zxygentoo/oberon-risc-hardcaml/docs/oberon-on-nexys4.jpg

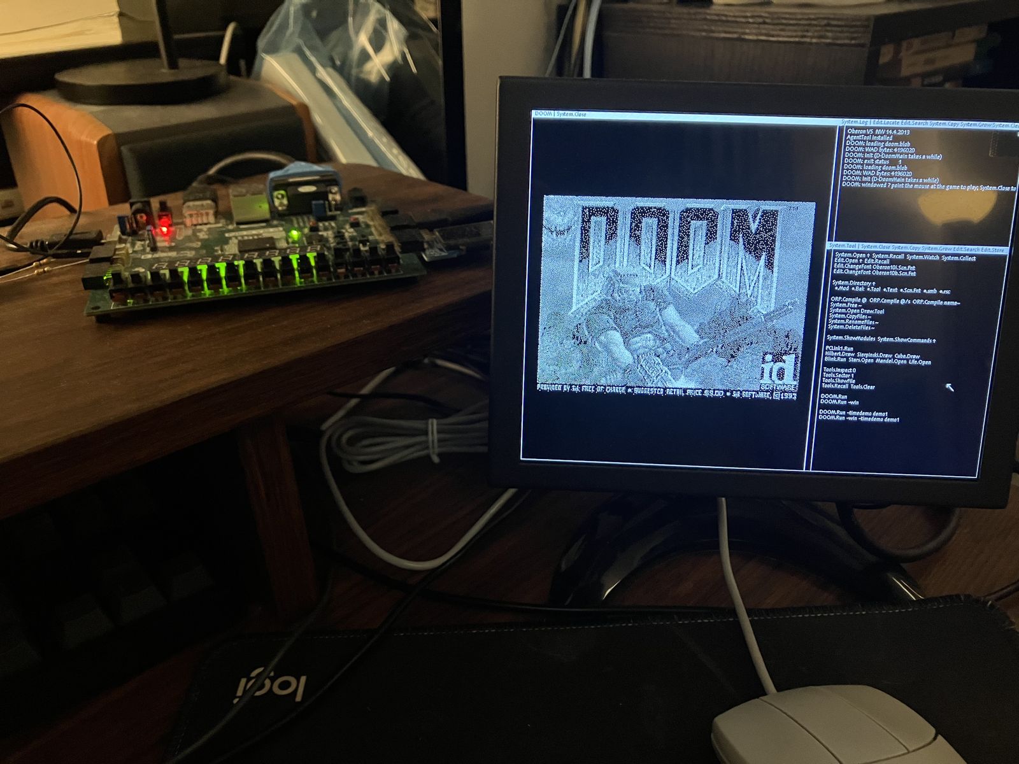
docs/oberon-on-nexys4.jpg
