zxygentoo/oberon-risc-hardcaml/(commit log)

2026-06-18 docs: record git-flow workflow conventions in AGENT.md
2026-06-18 docs: switch toolchain to OxCaml + Hardcaml v0.18~preview
    Record the toolchain decision in AGENT.md: the project builds on the 5.2.0+ox switch with Hardcaml v0.18~preview (the version docs.hardcaml.org documents), since vanilla opam tops out at v0.17.1. Adds locked decision #7 and rewrites the §9 toolchain/API notes (v0.18 labeled-arg shifts, log_shift ~f ~by, select ~high ~low, renamed int conversions, Rtl.print Rtl.Language.Verilog). Verified end-to-end on ox via a smoke test.
2026-06-19 chore: scaffold Phase 0 — dune project, oracle submodule, toolchain smoke
    Stand up the Hardcaml project on the OxCaml (5.2.0+ox) switch:
    - dune project: root (dirs lib test vendor); placeholder `risc5` design library
    (real modules from Phase 1).
    - Vendor the OCaml emulator as a git submodule (vendor/oberon-risc-emu-ocaml,
    pinned) and compile its lib/ into library `oracle` (Oracle.Risc/Fp/Boot_rom)
    via vendor/oracle — the in-process golden model for lockstep. The submodule is
    data_only so dune ignores its private project; the wrapper keeps it pristine.
    - test/test_scaffold.ml certifies the toolchain end to end (dune test green):
    oracle callable, Hardcaml build+simulate (v0.18 A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
2026-06-19 docs: refine §2 fidelity — faithful on timing, idiomatic on datapath
    Locate fidelity at the cycle-accurate boundary: mirror the sequential
    skeleton of RISC5.v (registers, stall/state-counter timing, multi-cycle
    units, interrupts) exactly, since that is what the oracle checks and what
    synthesis preserves; write idiomatic Hardcaml for the combinational
    datapath (shifters, ALU ops, muxes), where only the truth table is
    observable and synthesis re-maps structure freely.
2026-06-19 feat: add LeftShifter (LSL) as idiomatic log_shift one-liner
    Port of Oberon LeftShifter.v: y = x << sc (zero-fill, sc 0..31).
    Implemented with Hardcaml log_shift ~f:sll rather than Wirth radix-4 mux
    tree -- same combinational function; synthesis maps either form to the
    same LUT6 fabric (AGENT.md §2). I/O interface mirrors the Verilog ports
    (x[31:0], sc[4:0], y[31:0]); risc5.ml becomes the curated module index.
2026-06-19 build: generate opam file via dune for one-shot dep install
    (generate_opam_files true) + an (allow_empty) package stanza listing the
    toolchain (hardcaml, hardcaml_waveterm, ppx_hardcaml, ppx_expect, qcheck-core,
    core). opam install . --deps-only now reproduces the switch; the package carries
    dependency metadata only (the design lib is not published to opam).
2026-06-19 docs: correct §6 — co-located inline-test deps live in (libraries)
    (inline_tests (libraries ...)) only adds link-time deps to the generated test
    runner, not compile scope to the library modules. So tests co-located in a
    design module need their tooling (hardcaml_waveterm, qcheck-core) in the main
    (libraries). The emulator oracle is still kept out of lib by routing
    oracle-coupled lockstep tests to test/.
2026-06-19 test: co-locate LeftShifter tests (qcheck vs x lsl sc + waveform)
    Inline ppx_expect tests in left_shifter.ml: a 10k-case qcheck property
    against the pure-OCaml reference (x lsl sc) land 0xFFFFFFFF, and a frozen
    waveform of 1 << {0,1,4,16} plus 0xDEADBEEF << 4. lib/dune gains
    (inline_tests) + ppx_expect; hardcaml_waveterm and qcheck-core become library
    deps (co-located tests share the lib compile scope).
2026-06-19 docs: tighten §6 co-located-tests rationale (verified, not assumed)
    State co-location as the explicit default, with test/ reserved for
    oracle-coupled or system-level harnesses. Correct the mechanics caveat:
    the inline-test deps (hardcaml_waveterm, qcheck-core) are required in
    *every* profile — dune does not drop inline-test bodies in release — so
    the old "dropped from non-test builds" claim was wrong. The real reason
    co-location is acceptable is that those host-side deps never reach the
    generated Verilog (Rtl.print lowers the circuit graph, not OCaml deps).
    Verified empirically (dune 3.22, ppx_expect v0.18~preview):
    - (inline_tests (libraries …)) does not grant the lib compile scope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
2026-06-19 docs: add pre-commit gate (dune fmt + dune build @check)
    Before every commit, run dune fmt and dune build @check (the batch
    equivalent of merlin's in-editor diagnostics: type-checks every module
    and .mli, surfaces warnings which are errors in dev) and fix what they
    flag. If a flagged issue is not reasonable to fix — a false positive, a
    vendored/generated-code warning, or a fix that would compromise port
    fidelity (§2) — stop and notify the human instead of suppressing it.
2026-06-19 feat(right_shifter): add ASR/ROR unit (RightShifter.v) with co-located tests
    Port Oberon's RightShifter.v as the mirror of LeftShifter: a barrel
    right-shift selected by md — arithmetic (sign-fill, ASR) when md=0,
    rotate (wrap-fill, ROR) when md=1. Expressed idiomatically as two
    log_shift barrels (~f:sra, ~f:rotr) muxed on md; synthesis rebuilds
    Wirth's shared staged tree (AGENT.md §2). md = IR[16] in the core.
    Follows the locked conventions: right_shifter.{ml,mli} with the .mli
    contract owning the docs, and co-located ppx_expect tests — qcheck (10k)
    both modes vs plain-OCaml references, plus a frozen waveform showing
    ASR sign-flood and ROR half-swap/wrap.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
2026-06-19 refactor(shifters): drop now-unused shift helper from the public API
    With the ALU built as Option B — it does not fold the shifters in; their
    results join the result mux at the core — the `shift` combinational helper
    has no consumer. Inline it back into `create`, leaving each shifter with
    the clean I/O/create surface every other unit will have.
    The co-located tests already drove `create`, not `shift`, so they are
    unchanged and still pass.
2026-06-19 feat(alu): phase-1 step A — register-op result mux (ops 0,4..9) + waveforms
    New Alu module: the register-op results RISC5.v computes inline in its
    aluRes mux — MOV, the logic ops (AND/ANN/IOR/XOR), and ADD/SUB. Factored
    into its own unit for isolated tests (Option B: the shifts and MUL/DIV/FP
    are peer units selected at the Phase-4 core, so those op slots read as 0).
    Co-located tests:
    - qcheck, 20k cases over ops {0,4..9} vs an independent OCaml reference
    - two curated waveforms (display_rules) documenting the subtle bits: the
    ADD'/SUB' carry-in and the MOV forms
    The N/Z/C/OV flags follow in step B.
2026-06-19 feat(alu): step B — C/OV flags
    Carry/borrow and signed overflow from one-bit-wider add/sub: an unsigned widen gives result + carry/borrow (msb), a signed widen gives overflow (top two bits disagree). ADD/SUB own C/OV; every other op passes the current flags through. Shared addsub helper over (+:)/(-:). Verified by the 20k qcheck (res+c+ov vs OCaml refs) plus the carry-vs-overflow waveform.
2026-06-19 docs: swap phases 2↔3 (register file first); N/Z is Phase-4 (from regmux)
    N/Z derive from the final regmux (RISC5.v:159-160), not from the ALU's own result — so they're a core-integration signal, computed once at the CPU core. Move them off the Phase-1 row onto Phase 4; Phase 1 keeps C/V only. Reorder: register file (smaller, independent leaf) becomes Phase 2, MUL/DIV/FP becomes Phase 3. Make alu.mli's H comment phase-agnostic so it won't go stale on reorders.
2026-06-20 style: pin waveform widths (wave_width 4) and clarify alu MOV comment
    Narrow the frozen [%expect] waveforms to wave_width 4 with pinned ~display_width (alu 58, left/right_shifter 70) so a rolling v0.18~preview waveterm default can't silently reflow the frozen ASCII. Reword alu.ml's MOV comment to read the mux2 tree as a hardware if. Document the waveform-width rule in §6.
2026-06-20 refactor(registers): open! Base instead of Core
    registers.ml uses only Base-level APIs (Array, List, int =), so Base — the lean subset — is the right import, not Core; bang the Stdlib-replacement open per JS convention. Base resolves transitively via Hardcaml (as Core did), so no lib/dune entry needed. §9 reworded: Base + open! is the design-lib default, Core only where a module needs its extras.
2026-06-20 docs: split phase 3 into 3a (MUL/DIV) and 3b (FP units)
    3a's proof is pure-OCaml integer reference math (no fp_vectors); 3b's is
    the frozen fp_vectors.txt — a clean oracle seam that already existed
    implicitly in the old combined row. Also record the unsigned-MUL' high-word
    divergence in §8: Multiplier.v sign-extends C1 unconditionally, so MUL'
    computes B_u × C1_s while both emulators compute B_u × C1_u (differs in H
    only when C1[31]=1) — a new Phase-4 lockstep steer-around.
2026-06-20 feat(multiplier): iterative shift-and-add MUL unit (Multiplier.v)
    33-cycle sequential signed/unsigned 32x32->64 multiply, mirroring RISC5.v's
    skeleton exactly: 6-bit state counter S (run-gated, no reset), stall =
    run & ~(S==33), and the dual-role 64-bit P register that accumulates via a
    33-bit sign-extended add then shifts right one bit per multiplier bit.
    Idiomatic Hardcaml reg_fb for the two feedback registers (S in scope when
    defining P, so P's feedback can test S==0/S==32).
    Tests (co-located, AGENT.md §6): qcheck the full multiply against a pure-OCaml
    Int64 reference for both modes (2000 cases), encoding the hardware semantics
    (y always signed; x signed iff u=1, so unsigned MUL' = x_un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
2026-06-21 docs: clarify cycle-fidelity framing (§2); add Phase 9 optimization stretch
    §2 said cycle-accuracy is "what the oracle checks cycle-by-cycle" — but the OCaml
    oracle is instruction-level (ms-clock injected via set_time, steps by instruction),
    so it proves behavioral correctness and needs no cycle-accuracy. Reframe: cycle-
    fidelity is held for the exhaustive Phase-8 equivalence proof vs RISC5.v, RISC5.v as
    a cycle-level debugging oracle, and the bright-line discipline — not for the
    behavioral pyramid (Phases 4-5). Add Phase 9 (stretch): optimize from the verified,
    Phase-8-proven baseline, judged against the ISA/oracle with cycle-accuracy relaxed.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
2026-06-21 feat(divider): iterative restoring DIV unit (Divider.v)
    33-cycle sequential signed/unsigned divider, the Multiplier's twin: same 6-bit
    state counter S (run-gated, no reset), stall = run & ~(S==33), and a dual-role
    64-bit RQ register holding remainder|quotient (high|low). S=0 loads |x| into the
    low half; S=1..32 each run one restoring step -- shift {R,Q} left one bit
    (RQ[62:31]), trial-subtract y, then keep the difference (quotient bit 1) or
    restore the old remainder (quotient bit 0). Signed mode divides |x| then
    sign-corrects the outputs to floored division with a non-negative remainder
    (-q-1 = ~q in two's complement).
    Precondition y in [1, 2^31-1] (Wirth's // y > 0): the restoring step's
    r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
2026-06-22 feat(fp-adder): pipelined FPAdder + FLT/FLOOR (FPAdder.v)
    3-stage pipelined IEEE-754 single add/sub plus the FLT (int->float) and FLOOR
    (float->int) conversions -- a faithful port of FPAdder.v: 2-bit State counter,
    run-gated with no reset, stall = run & ~(State==3), and the three pipeline
    registers (x3/y3 align, Sum add, t3 post-normalize). The combinational datapath
    is idiomatic Hardcaml (log_shift for the denormalize/normalize barrel shifts),
    but the leading-one detector + shift-count encoder are transliterated bit-for-bit
    from the RTL -- a priority encoder is where an idiomatic rewrite could silently
    diverge. FLT/FLOOR select via the u/v modifier bits; the facade exposes Fp_adder.
    Verifi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
2026-06-22 test(cosim): RTL-fidelity co-sim via Verilator (FPAdder)
    Opt-in harness (not dune runtest) confirming the Hardcaml design is bit-exact to
    Wirth's original Verilog: drive the reference RTL through Verilator and compare
    against the port. The simulation preview of the Phase-8 hardcaml_verify proof,
    and the project's *fidelity* oracle -- distinct from the OCaml emulator's
    behavioral/system role.
    dump_fp_adder.ml Hardcaml Fp_adder -> "x y u v z" over a stimulus set
    fp_adder.cpp Verilator harness: replay each line through FPAdder.v, compare z
    run.sh build dumper -> dump -> verilate -> cross-check
    README.md purpose, deps, how to run, how to add a unit
    bash test/co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
2026-06-22 docs: reframe verification (§6) — two oracles (emulator + RTL co-sim)
    Name the two complementary oracles explicitly: the OCaml emulator (system-state,
    instruction granularity, layers 4-5) and the original Verilog via Verilator
    (wire-state, cycle granularity, our test/cosim/) -- the §2 fidelity authority,
    added as pyramid layer 3 (exhaustively at layer 6). Records that every §8
    divergence is emulator-vs-RISC5.v with the port following the RTL (co-sim proves
    it), makes the FP-vector replay reachable-domain, and adds the FP FLT/FLOOR
    denormalize-fill divergence to §8. Tooling reality in §9: hardcaml_verify
    installed, hardcaml_of_verilog blocked on the preview (jsonaf portability),
    hardca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
2026-06-22 feat(fp-multiplier): pipelined iterative FPMultiplier.v port + timing test
    Port Oberon's FPMultiplier.v (the RISC5 FML unit): a 24-bit shift-and-add
    mantissa multiplier — the integer Multiplier in miniature — wrapped in the
    combinational FP exponent/round/repack logic. Mirrors the RTL's sequential
    skeleton (AGENT.md §2): a 48-bit dual-role P register and a run-gated 5-bit
    state counter S, with stall = run & ~(S==25).
    The co-located expect test pins the cycle timing (stall envelope S 0->25) plus
    one oracle-free sanity value (FML 2.0*2.0 = 0x40800000); exhaustive value
    correctness is the Verilator co-sim's job. Re-export Fp_multiplier from the
    curated risc5.ml index.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
2026-06-22 test(cosim): consolidate FP dumpers + fetch reference RTL on demand
    Consolidate the per-unit dumpers into a single dump_fp.ml selected by a
    unit-name argument: a shared run->drain->read protocol over a small per-unit
    `driver` record (the FP units differ only in the u/v modifiers and the A/M/D
    vector tag). Adds the fp_multiplier co-sim harness.
    Make the co-sim painless for a fresh clone. The original Project Oberon Verilog
    is not vendored (unclear licensing); run.sh's ensure_rtl fetches
    OStationVerilog.zip on demand into _po/ and checksum-verifies it against
    test/cosim/rtl-sources.txt (per-file SHA-256 pins — a mismatch means upstream
    drifted from the revision the port and AGENT.md §8 wer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
    [fp_adder.cpp, fp_multiplier.cpp]
2026-06-22 feat(fp-divider): restoring-division FPDivider.v port + co-sim
    Port Oberon's FPDivider.v (the RISC5 FDV unit): a restoring-division divider
    forming the 24-bit-mantissa quotient over 26 cycles, under the same FP
    exponent/round/repack wrapper as the multiplier — the dual of shift-and-add.
    Mirrors the RTL skeleton (AGENT.md §2): R (24-bit remainder) + Q (26-bit
    quotient) + a run-gated 5-bit S, stall = run & ~(S==26). R's next value and Q's
    next bit both feed off the same trial subtraction, so they are forward-declared
    wires closed through reg (the register breaks the apparent cycle).
    Co-located test pins the timing (stall S 0->26) + a sanity FDV 6.0/2.0=3.0; wire
    its driver into the shared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
    [fp_divider.cpp]
2026-06-22 test(fp): always-on value-correctness replays (FAD/FML/FDV) via shared Fp_replay
    Add the FP units' behavioural layer to `dune runtest`, independent of the opt-in
    Verilator co-sim (AGENT.md §6): replay the frozen fp_vectors result columns
    against the Hardcaml ports, plus a fuzz vs Oracle.Fp.
    FML/FDV have no emulator-vs-RTL divergence (verified: 2576/2576 frozen + 20k
    random each, 0 fail), so they need no steering and collapse to one
    Fp_replay.simple_value_test call apiece. The adder keeps its reachable-domain
    steering (the FLT/FLOOR magic operand) inline but now shares the sim-drive
    protocol, vector loader and RNG via Fp_replay — the per-unit `run` closure hides
    the u/v interface differen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
2026-06-22 feat(cpu-core): fetch/decode/stall spine (Phase 4.0)
    Stand up Risc5_core, the port of RISC5.v: the final SoC-facing I/O interface,
    and the fetch/decode/stall spine in one Always.compile block mirroring Wirth's
    single always @(posedge clk). This slice brings:
    - PC/IR/stallL1 — the three fetch-timing registers (the other nine land in
    4.1-4.5); faithful no-reset registers, rst_n reaching the datapath as logic.
    - decode of the four mode bits + LDR/STR (the rest is decoded per later slice).
    - stall aggregation (stallL0 | stallX; the unit stalls OR in at 4.2).
    - the reset/stall/step next-PC ladder (branch/intAck/RTI join at 4.3/4.5).
    - final memory-bus control strobes rd/wr/ben; adr's data br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
2026-06-22 feat(cpu-core): register-op datapath + lockstep (Phase 4.1)
    Wire the register-op datapath into the core and prove it against the oracle.
    Datapath (4.1a):
    - Operand path: the register file (Registers), ira0 (branch-link write addr),
    and the C1 immediate mux; B/C1 fan out to the shifters + Alu into the
    op-indexed result mux (MUL/DIV/FP slots read 0 until 4.2).
    - Writeback + flags: regmux (the ALU result for a register op), regwr, and the
    N/Z/C/OV registers (N/Z from the written value, C/OV from the Alu). outbus now
    drives A (RISC5.v:132, the ~ben case) — faithful, and it makes the datapath
    observable instead of dead-code-pruned.
    - registers.ml: name the regfile memory ("regfile")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
2026-06-22 feat(cpu-core): multi-cycle units MUL/DIV/FP + H (Phase 4.2)
    Wire the multi-cycle units into the core and verify all 16 register ops.
    - Instantiate Multiplier/Divider (B/C1, the inverted u-bit) and the three FP
    units (B/C0, with FSB's operand-2 sign flip); their results fill result-mux
    slots 10..15. OR the five unit stalls into the stall aggregation (which makes
    regwr a forward wire, like regmux). Add the H register (MUL high word / DIV
    remainder), now feeding the Alu's MOV' H-read.
    - Co-located waveform: a MUL freezes the core (PC/IR held, stall high) then
    writes back product[31:0] + H on the cycle stall drops.
    - test/test_cpu_lockstep.ml: extended to ops 0..15 — multi-cycle re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
2026-06-22 test(fp): migrate fuzz passes to QCheck + restructure
    Bring the FP units' random fuzz passes onto QCheck, matching the lib unit tests
    and the CPU lockstep: int32 generators give boundary coverage (0/min/max) and
    shrink a failure to a minimal counterexample. The deterministic parts are
    unchanged — the frozen fp_vectors replays and the FLT/FLOOR edge-value list stay
    plain loops (they were never randomized).
    Also break the two monolithic let () bodies apart for readability:
    - fp_replay.ml: simple_value_test -> replay_simple + fuzz_xy + a composer.
    - test_fp_adder.ml: -> make_run / replay_reachable / fuzz_conversions + a driver.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
2026-06-22 feat(cpu-core): branches — cond, target mux, link-to-R15 (Phase 4.3)
    Wire the branch control path (RISC5.v:137-153):
    - cond: the branch condition (the §7 cc table on N/Z/C/OV/S, negated by IR[27]).
    - pcmux0: a taken branch goes to PC+1+disp (relative) or R.c>>2 (register), else
    falls through to nxpc; pcmux now uses pcmux0.
    - link: a taken linking branch (BR & cond & v) writes the return byte-address
    {PC+1, 2'b0} to R15 (= ira0, wired in 4.1) via regmux/regwr.
    Co-located waveform: a taken BL jumps and links R15; a not-taken branch falls
    through.
    Lockstep (test/test_cpu_lockstep.ml): a second QCheck test, 50k branch cases
    reusing the create/step/agree harness. Targets are steered into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
2026-06-22 feat(cpu-core): load/store data path (Phase 4.4)
    Wire the load/store data path onto the 2-cycle stallL0 dance from 4.0:
    - off (IR[19:0], 20-bit signed) and the data address B[23:0] + sign-extend(off);
    adr is that data address during stallL0, else the fetch address.
    - inbus1: a byte load selects the lane at adr[1:0] from inbus and zero-extends, a
    word load passes inbus through; this feeds regmux's LDR term, and regwr gains
    the load write enable.
    - outbus: a byte store replicates A[7:0] into the addressed lane, a word store
    drives A.
    Co-located waveform: a word load and a byte store, each a 2-cycle access (data
    address + rd/wr strobe while PC/IR freeze, then a bubble).
    Lockstep (test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
2026-06-22 feat(cpu-core): interrupts — intAck, vector dispatch, RTI restore (Phase 4.5)
    Wire RISC5.v's interrupt FSM, the last slice of the CPU core:
    - Five registers (RISC5.v:34-35,178-182): irq1 (edge detector), intEnb
    (STI/CLI-written), intPnd (pending — set on a rising IRQ edge, cleared on
    ack), intMd (in-handler — set on ack, cleared by RTI), and SPC = {flags,
    return PC}.
    - intAck (RISC5.v:149) = intPnd & intEnb & ~intMd & ~stall.
    - pcmux (RISC5.v:150-152) becomes the priority ladder reset > stall > intAck
    (-> vector address 1) > RTI (-> SPC[21:0]) > branch/step.
    - The flags gain an RTI restore from SPC[25:22] (RISC5.v:159-166).
    - RTI and STI/CLI decode (RISC5.v:96,181).
    Verificati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
2026-06-22 docs: mark Phase 4 (CPU core) complete
    The full RISC5.v core is ported and verified across the 4.0-4.5 slices. Note in
    the proof column that the interrupt FSM (4.5) is the one part with no OCaml
    oracle (the emulator models no interrupts), so it is checked by a behavioural
    waveform against RISC5.v rather than by instruction lockstep.
2026-06-22 test(cosim): cycle-fidelity check — assert RTL stall length == port (FP units)
    The FP co-sim asserted only RTL z == port z (each side read when its own stall
    dropped), so a cycle-count divergence would have slipped through. Add a
    stall-length comparison on top:
    - dump_fp.ml: drive now counts the clock cycles with run asserted until stall
    drops (= the unit's state-counter terminal) and dumps it as a trailing column.
    - fp_{adder,multiplier,divider}.cpp: run_op counts the RTL's stall the same way,
    and main compares it to the port's, exiting nonzero on a value OR cycle
    mismatch.
    Verified against the reference Verilog (bash test/cosim/run.sh): all three units
    bit-exact AND cycle-exact o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
    [fp_adder.cpp, fp_divider.cpp, fp_multiplier.cpp]
2026-06-22 style(cpu-core): shrink MUL tail waveform to fit its 3 cycles
    The MUL test's tail [%expect] rendered at display_width 70 (sized for the head's
    5 cycles) but carries only 3 cycles of content, leaving two empty cycle-columns.
    Drop it to 44 — the 58/70-for-4/5-cycle progression puts 3 cycles at ~44 — so
    the result (regmux = 0x2A) keeps ~2 trailing spaces, unclipped. The head stays
    at 70 (it needs all five). Waveform only; no logic change.
2026-06-22 refactor(cosim): hoist shared tick+drain protocol into fp_cosim.h
    The three FP co-sim harnesses each carried an identical clock tick() and a
    run->drain->count run_op() — the latter triplicated when the cycle-fidelity
    check landed. Extract both into a templated fp_cosim.h (over the Verilator top
    type, which all three units expose as clk/run/stall/z/eval), so the drive
    protocol and its cycle count have a single definition. Each <unit>.cpp is now
    just its stimulus loop; the main()s stay local because they legitimately differ
    (the adder's u/v modifiers, the dumped-line arity). -79 lines net.
    Verified via test/cosim/run.sh: all three still bit-exact AND cycle-exact
    (26304 / 22576 / 22576 stimu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
    [fp_adder.cpp, fp_divider.cpp, fp_multiplier.cpp]
2026-06-23 docs: flag hardcaml_step_testbench as a Phase-6 evaluation
    Researched hardcaml_step_testbench and hardcaml_event_driven_sim for our testing.
    event_driven_sim is an event-driven paradigm with no role in this single-clock
    synchronous design. step_testbench (a testbench monad with concurrent agents)
    doesn't fit the white-box, cycle-exact core/lockstep tests, but is well-suited to
    the Phase-6 serial peripheral protocols (UART/SPI/PS2) — noted in the plan to
    evaluate then. Both install clean on ox (2 packages, deps already present);
    neither is installed.
2026-06-23 docs: clarify §2 fidelity — semantics not surface, idiomatic readable code
    Sharpen the mandate with what we settled while refactoring the core: Phases 0-8
    are cycle-/bit-exact *behaviour*, not surface-syntax/style matching to RISC5.v —
    so write idiomatic, clean, readable Hardcaml. Records bound to meaningful names
    with dot-notation field access are a free namespace; comment the why and the
    load-bearing mechanic, not a line-by-line footnote to the RTL. The only surface
    held fixed is the timing skeleton and the register names (the lockstep reaches
    them by name).
2026-06-23 refactor(cpu-core): stage create as decode/execute/memory; dot-access; comment pass
    Reorganize risc5_core.ml for readability — behaviour byte-identical (the 200k-case
    lockstep and the co-located waveforms are all unchanged; same netlist, pure
    source-level reshaping):
    - Factor the datapath into named stages: decode (IR -> fields record), execute
    (shifters/ALU/MUL/DIV/FP + result mux), memory (address, byte lanes, strobes).
    create now reads top-to-bottom as the loop: decode -> fetch operands -> execute
    -> memory -> control -> writeback -> commit.
    - Uniform dot-access: bind sub-modules and stages to meaningful names and reach
    their outputs by field (alu.res, mul.stall, ex.result, mem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
2026-06-23 test(cpu-lockstep): rename arbitrary_* generators to seed_*
    The QCheck generators feed decode/decode_branch/... which turn a raw draw into a
    lockstep case, so `seed` reads better than `arbitrary` (seed -> decode -> case).
    Pure rename; lockstep unchanged.
2026-06-23 docs(lib): comment cleanup — why/mechanic over RTL-line footnotes (FP + mul/div + alu)
    Apply the §2 "semantics not surface" comment philosophy to the remaining design
    modules. The inline Verilog-expression footnotes that restated each line in RTL
    notation — (* {P[63],P[63:32]} *), (* P[0] ? y : 0 *), (* e0 - 127 + P[47] *) —
    become plain-English why/mechanic notes, or are dropped where the header already
    covers them; the header meta-claims ("each create line is tagged with the wire
    it ports") go. High-level "ports <File>.v" pointers, AGENT.md §N refs, mux-arm
    labels and register-role notes stay; alu's 0x53-vs-0xD0 §8 divergence why was
    made explicit.
    Touched: alu, multiplier, divid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
2026-06-23 refactor(cpu-core): rename stage bindings d->dec, ex->exe for readability
    The decode and execute stage results in create read clearer spelled out (dec,
    exe) than the single/double-letter d/ex, including in the execute/memory helper
    params (~(dec : decoded)). Pure rename — behaviour byte-identical (200k lockstep
    + every co-located waveform unchanged; the (--) naming strings are untouched).
2026-06-23 refactor(fp-adder): extract leading-one detector + encoder as shift_count
    Stage 2's ~48-line leading-one detector (z24..z2) + shift-count encoder
    (sc4..sc0) move into a top-level shift_count helper (s -> sc, one in / one out),
    so create's Stage 2 reads as four lines instead of a wall of priority-encoder
    boolean logic. The helper carries the §2 note that it's transliterated
    bit-for-bit — a priority encoder is exactly where an idiomatic rewrite could
    silently diverge.
    Pure refactor, netlist byte-identical: the FP frozen vectors, the timing
    waveform, and the Verilator co-sim (26304 stimuli, 0 value-mismatch, 0
    cycle-mismatch -> bit- AND cycle-exact to FPAdder.v) are all unchanged. create
    bo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
2026-06-24 feat(sram): 1 MiB single-port async SRAM model, byte-enable writes
    Second Phase-5 memory module. Models the OberonStation's external async SRAM as four byte-lane memories (256 Ki x 8) sharing the word address; per-lane write-enable (wr & (~ben | lane==k)) is the SRbe semantics directly, avoiding a read-modify-write for sub-word stores. Async read; zeroed at reset (matches the oracle).
    Single-port by design — the video-DMA address-steal mux + stall_x live at the SoC level (RISC5Top's SRadr mux), which is why the core stalls during DMA. Named Sram (not Ram) to avoid shadowing Hardcaml.Ram under open Hardcaml.
    Tests: qcheck 500 mixed word/byte sequences vs a word-array model + a frozen wave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
2026-06-24 feat(soc): minimal Phase-5 SoC — core + boot ROM + RAM + address decode
    Wires the RISC5 core to Prom + Sram through RISC5Top's decode: codebus = adr[23:14]==0x3FF ? rom : ram (fetch), inbus = adr[23:6]==0x3FFFF ? io : ram (load), stores to Sram. The adr->mem->codebus/inbus feedback is broken by the core's pc/ir registers, so codebus/inbus are wires assigned after the core is built.
    Skeleton: irq/stall_x tied low, MMIO read mux stubbed to 0 — the ms-timer + IO mux (5.2b) and state-as-outputs for the hardcaml_c lockstep (5.2c) come next. Integration test (no oracle): a hand-assembled boot stub fetches MOV/ST/LD from ROM and round-trips a word through RAM (R1=R2=0x55 via the named regfile)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
2026-06-24 docs: retarget board to Nexys 4 (non-DDR), Cellular PSRAM memory story
    Physical board is the original Digilent Nexys 4, not the Nexys 4 DDR. External memory is 16 MiB Cellular PSRAM (Micron M45W8MW16) with an async-SRAM interface and async auto-refresh, so the Phase-7 memory layer becomes a light 16/32-bit width-adapter FSM over an SRAM controller with ~70 ns wait-states through the existing stall path (no MIG/DDR2). Rewrites section 4 and its companions (2.3/2.5/3/5 Phase 7) plus the board name in dune-project and the .opam. Grounded in _po/nexys4_rm.pdf section 3.
2026-06-24 feat(soc): millisecond timer + MMIO read mux (5.2b)
    RISC5Top's free-running ms timer: a clocks_per_ms prescaler (cnt0) raises limit once per ms, driving the core's irq and ticking the ms counter cnt1 (read at MMIO word 0). The MMIO read mux routes word 0 -> cnt1, other words -> 0 (peripherals are Phase 6). New ?clocks_per_ms param (default 25000 = 1 ms @ 25 MHz; faithful default, lowered in tests).
    Tests: cnt1 ticks to 2 after 60001 cycles at the faithful 25000 prescaler; the MMIO mux distinguishes IO (R1 = cnt1, non-zero) from RAM (R2 = 0x55); the 5.2a round-trip stays green.
2026-06-24 docs: reframe Phase-5 lockstep backend — interpreter, not hardcaml_c
    Profiling (2026-06-25) showed the plain Cyclesim interpreter is fast enough for the boot lockstep (~0.39 M cycles/s -> ~1 min boot golden; trace_all for lookup_* is free), while hardcaml_c gives only ~3.5x at the cost of minutes per -O2 compile of a 63 MB / ~1M-line eval.c, and hardcaml_verilator won't build vs Verilator 5.048. Updates AGENT.md sections 5/6/9 and the soc.{ml,mli} comments; the state-as-outputs / debug-bundle plan (5.2c) is dropped since the interpreter's lookup_reg/lookup_mem reach the state directly.
2026-06-24 docs: reframe Phase-5 verification — boot-handoff checkpoint, SPI into Phase 5
    Per-instruction oracle lockstep through a boot is the wrong tool: the §8
    code-address skew while running from ROM, the interrupt-free oracle, its
    injected vs cycle-derived ms-clock, and SD/timer poll timing all diverge
    step-by-step without diverging in result. The §8 skew is confined to ROM and
    self-heals in low RAM, so boot is verified by a checkpoint at the OS handoff.
    SPI/SD — the one peripheral boot needs — moves into Phase 5; the rest stay
    Phase 6.
    Updates §5 plan (Phase 5/6 rows), §6 layer 5, and §8 addressing.
2026-06-24 feat(spi): SPI master — faithful port of SPI.v
    One 32-bit shift register serves two SD-card rates (slow clk/64 byte for init,
    fast clk/3 word for bulk), selected by `fast`. Cycle-accurate to SPI.v: the
    tick clock-divider, bitcnt, the rdy handshake, and the four-lane chained shift
    permutation that serialises fast words LSByte-first while keeping each byte
    MSbit-first — transcribed bit-for-bit since it is observable (§2). Active-low
    synchronous reset woven into next-state, matching the core's style.
    Co-located tests: slow loopback (512 cycles, 0xA5 round-trips), fast loopback
    (96 cycles, 0x12345678 round-trips — exercises the permutation), and a short
    structural waveform. The exhaustiv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
2026-06-24 feat(soc): wire the SPI master into the SoC
    RISC5Top SPI MMIO: a store to word 4 pulses spiStart (dataTx = outbus),
    word 5 is the 4-bit spiCtrl (bit 2 = fast); reads return data_rx (word 4)
    and {31'b0, rdy} (word 5). Adds a miso input and mosi/sclk outputs — the
    SD card is off-chip, driven test-side. spiStart/spiCtrl are transcribed
    verbatim from RISC5Top; store routing is unchanged (the SRAM tristate is
    .T(~wr) with no ioenb gate, so unconditional RAM writes stay faithful).
    Integration test: a boot-style exchange (start, poll rdy, read back) with
    a loopback SD card round-trips 0xA5 through the full MMIO→SPI→MMIO path.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
2026-06-24 perf(test): build the SRAM qcheck sim once (47 s → 0.5 s)
    The SRAM property created a fresh Cyclesim sim inside the per-case function,
    rebuilding the 1 MiB memory model (4 × 256 Ki byte lanes) on all 500 sequences —
    ~48 s, the dominant cost of `dune runtest`. Build the sim once and zero the
    16-word test window at the start of each sequence instead. Full `dune runtest`
    drops from ~60 s to ~2.5 s.
2026-06-24 test(cosim): RTL-fidelity co-sim for the SPI master
    Verilator co-sim proving Hardcaml Spi is bit- and cycle-exact to SPI.v — the
    serial-peripheral analog of the FP units' z+stall-length check, and the closing
    gap noted in spi.ml (layer-3 fidelity was deferred there).
    dump_spi.ml drives Risc5.Spi over 658 transfers (corner words x both rates +
    fuzz, biased to the cheap fast mode) with a deterministic, recorded per-cycle
    MISO — independent of MOSI, not loopback, so a sample-timing bug can't hide
    behind MISO happening to equal the bit being shifted out. Each cycle is encoded
    as one hex digit (miso/rdy/sclk/mosi); spi.cpp replays the recorded MISO through
    SPI.v, drains on the RTL's own rdy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
    [spi.cpp]
2026-06-24 test: retire Phase-0 scaffold smoke, subsumed by the real suite
    The scaffold certified three wiring facts — oracle callable on ox,
    Hardcaml build+Cyclesim, hardcaml_waveterm render — each now exercised
    many times over by the real tests (every FP replay and the CPU lockstep
    link/call the oracle; all test_* build and simulate circuits; the lib's
    co-located let%expect_test waveforms drive hardcaml_waveterm). It was a
    Phase-0 milestone marker with no remaining coverage.
    Drop test_scaffold from test/dune and update the four AGENT.md
    references (§6 harness/mechanics, §9 "verified end to end" + repo
    layout) to point at the real suite. §5 Phase-0 row kept as history.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
2026-06-25 refactor(cosim): split fetch from runner, table-drive units, add @cosim alias
    run.sh had grown to ~150 lines doing four unrelated jobs (env, RTL
    provenance/fetch, per-unit orchestration with duplicated cosim_unit /
    cosim_spi / run_one, dispatch). Untangle it:
    - Extract the fetch + checksum-verify (ensure_rtl) into a standalone,
    toolchain-free fetch-rtl.sh. rtl-sources.txt stays as the reviewable
    provenance pin.
    - Collapse the per-unit functions to a units_table (one row each:
    name .v top .cpp dumper) driving a single cosim_unit. Adding the CPU
    core / peripherals is now a one-row edit. SPI's only difference (own
    dumper, no fp_vectors arg) is one column + one conditional.
    - Add a `d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
2026-06-25 fix(test): resolve boot-checkpoint disk path from project root
    The disk image path was relative to the test run directory
    (_build/default/test), so it only resolved when launched by the
    @boot_checkpoint rule — `dune exec -- test/test_boot_checkpoint.exe`
    from the repo root failed with "No such file or directory".
    Find the project root dynamically by walking up for the dune-project
    marker, then resolve the disk against it. The marker sits at both the
    real root and dune's _build/default mirror, with the disk at the same
    vendor/ offset under each, so it works from any cwd — the rule and a
    bare `dune exec` alike. Verified: CHECKPOINT PASS via both.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
2026-06-25 docs: split Phase 6 into 6a/6b; defer step_testbench + event_driven_sim
    Phase 6 is now 6a (remaining peripherals, each ported + unit-verified with the proven co-located + Verilator-cosim stack) and 6b (SoC top + the visual golden, extending the boot-handoff checkpoint over the framebuffer RAM region).
    hardcaml_step_testbench + hardcaml_event_driven_sim were evaluated (an SPI A/B spike) and deferred: heavier than the manual Cyclesim loop for our single-driver serial peripherals, and the cosim is their fidelity oracle. Revisit only at the PS/2 mouse (bidirectional concurrency).
2026-06-25 feat(uart): RS232T transmitter — faithful port of RS232T.v
    First Phase-6a peripheral. Baud divider (tick) + 9-bit shift register with implicit UART framing: loading {data, 1'b0} on start drops the start bit into the LSB, and shifting 1s in from the top yields the stop bit and idle line; bitcnt counts the 10 bit-times, run/rdy frame the transfer. fsel selects 19200/115200 (clk/1302 or clk/217 at 25 MHz). Sequential skeleton mirrors the RTL exactly; active-low synchronous reset woven into next-state (clock-only Reg_spec).
    Co-located tests (proven stack): functional frame decode (sample txd at bit centres, recover start/8-data-LSB-first/stop + rdy handshake), both-baud-rates, qcheck round-tr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
2026-06-25 test(cosim): RTL-fidelity co-sim for the RS232T transmitter
    Cycle-by-cycle Verilator check of Risc5.Rs232t vs _po/verilog/src/RS232T.v, following the SPI template: dump_rs232t drives (fsel, data) and records per-cycle (rdy, txd) over corner bytes in both baud rates + fuzz; rs232t.cpp replays the same stimuli through RS232T.v and asserts (rdy, TxD) match every cycle plus equal frame length. Output-only, so no value column — txd is the value, checked each cycle.
    Passes: 88 stimuli, 0 wave-mismatch, 0 cycle-mismatch — bit-exact and cycle-exact. Wires the unit into run.sh's units_table + the @cosim dune rule, pins RS232T.v in rtl-sources.txt, and exports Risc5.Rs232t (the cosim is its first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
2026-06-25 refactor(cosim): extract shared stall-based runner; collapse FP harnesses
    run_drain_cosim (+ cosim_open, Unit, parse_xy/parse_xyuv) in fp_cosim.h now owns the open -> run -> drain -> compare -> summary loop, so fp_adder/multiplier/divider.cpp drop to ~17-line shells (name the Unit, pick the parser). All five cosim units stay bit- AND cycle-exact (FP x3 + SPI + RS232T, 0 mismatches).
    Serial harnesses (spi/rs232t) left as-is; AGENT.md 6a notes a closing cosim-dedup pass (a shared serial runner across SPI/RS232x/PS2) deferred to the end of 6a.
    [fp_adder.cpp, fp_divider.cpp, fp_multiplier.cpp]
2026-06-25 feat(uart): RS232R receiver — faithful port of RS232R.v
    The receiver half of the UART (MMIO words 2/3). Three ideas beyond the transmitter: a 2-FF synchronizer (Q0/Q1) on the async rxd with start-edge detect (Q1 & ~Q0); mid-bit sampling (midtick = tick == limit/2) for noise margin; and nine windows (start + 8 data) with the start bit shifted off an 8-bit shreg so it ends holding the byte LSbit-first. run/stat frame the receive; done_ (a keyword-dodge for done) or reset clears rdy. Clock-only Reg_spec, reset woven into run/stat per the RTL.
    Co-located tests: recover-a-byte + done clears rdy, both baud rates, qcheck round-trip, and a start-detect waveform (rxd -> q0/q1 -> start_edge -> run)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
2026-06-25 test(cosim): RTL-fidelity co-sim for the RS232R receiver
    The receiver is input-driven, so a fixed-length trace replay: dump_rs232r plays the sender (drives a frame on rxd + a done_ ack, both baud rates + fuzz) and records per-cycle (done_, rxd, rdy) + the recovered byte; rs232r.cpp replays the same rxd/done waveform through RS232R.v and asserts RTL rdy == port's every cycle plus RTL data == port's whenever rdy is high.
    Passes: 52 stimuli, 0 value-mismatch, 0 wave-mismatch — bit- and cycle-exact. Wires the unit into run.sh + the @cosim rule, pins RS232R.v, exports Risc5.Rs232r. (The reference port is RxD, not rxd.)
    [rs232r.cpp]
2026-06-25 feat(kbd): PS/2 keyboard receiver — faithful port of PS2.v
    Recovers bytes from the device-clocked PS/2 stream. Three ideas beyond the UART: clock recovery (shift = Q1 & ~Q0 on each ps2c falling edge — the device's clock is the timing, no baud divider); a walking start bit (an all-1s 11-bit shreg where the start bit walks to bit 0 in exactly 11 shifts, self-timing the frame — no bit counter); and a 16-byte FIFO (a multiport_memory, one sync write at inptr on endbit + one async read at outptr, like the register file) buffering keystrokes. done_ (keyword-dodge) pops. Clock-only Reg_spec, reset woven into shreg/inptr/outptr per the RTL.
    Co-located tests: recover-a-scancode + done pops; th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
2026-06-25 test(cosim): RTL-fidelity co-sim for the PS/2 keyboard
    Input-driven fixed-length replay like RS232R: dump_ps2 plays the keyboard (clocks 11-bit frames on ps2c/ps2d + a done_ pop, corners + fuzz) recording per-cycle (done_, ps2c, ps2d, rdy) + the recovered byte; ps2.cpp replays the same waveform through PS2.v and asserts RTL rdy == port's every cycle plus RTL data == port's when rdy. shift is ps2c-derived (trivially identical); FIFO depth is the lib test's job. The FIFO pointers wrap across frames.
    Passes: 48 stimuli, 0 value-mismatch, 0 wave-mismatch — bit- and cycle-exact. Wires the unit into run.sh + the @cosim rule, pins PS2.v, exports Risc5.Ps2. (PS/2 ports are PS2C/PS2D, capitalized.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
    [ps2.cpp]
2026-06-25 feat(video): video controller — faithful port of VID60.v
    1024x768@60 1bpp display controller: a VGA timing generator (hsync/vsync/blank +
    a 32-bit pixel shift-out) on the 65 MHz pixel clock pclk, and a framebuffer DMA that
    reads one word (= 32 px) every 32 px on the 25 MHz clk and drives req (= core stallX).
    Two clock domains. Per AGENT.md §3 the clock *generation* is the Phase-7 board shim, so
    VID60.v's internal DCM/BUFG are dropped and pclk is an input; the sim drives both clocks
    via Cyclesim's By_input_clocks at the real 65:25 = period 5:13 ratio. The pclk datapath
    (counters, comparator-free vblank/hblank, the SR-latch syncs, the pixel serializer,
    vidadr) is a direct transliteration.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
2026-06-25 feat(mouse): PS/2 mouse — faithful port of MousePM.v
    Bidirectional PS/2 mouse (the MouseP module) with the IntelliMouse scroll-wheel init magic.
    Two phases sequenced by sent (0..7), run = sent==7: an INIT phase where the host transmits a
    7-command set-sample-rate sequence via a request-to-send handshake (pull msclk low ~1.1 ms,
    then clock the command out on msdat while the device clocks), then a REPORT phase that
    assembles 33-bit movement packets (walking start bit, as in PS2.v) and accumulates x+=dx,
    y+=dy, btns.
    Hardcaml has no inout, so the open-drain msclk/msdat (RTL: line = drive ? 0 : z) split into
    resolved-value inputs + drive-low outputs (msclk_oe = req, msdat_oe = ~tx[0]); the pa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
2026-06-25 test(mouse): device-model test — init handshake + report accumulation
    A plain-Cyclesim loop plays a PS/2 mouse against the DUT: drives all 7 commands through the
    bidirectional request-to-send handshake to run=1, then streams 3-byte movement packets and
    checks the accumulated x/y/btns. Two reports verify accumulation (x += dx, not assignment):
    report 1 -> x=3 y=5, report 2 -> x=5 y=6. The open-drain msclk/msdat are resolved manually
    in the harness (wired-AND of the DUT's *_oe outputs + the device's drive) — no inout/4-state
    sim needed, since the port splits each line into a drive-low output + a resolved input.
    (Evaluated hardcaml_step_testbench for this and rejected it: the device model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
2026-06-25 test(cosim): RTL-fidelity co-sim for the PS/2 mouse
    Bidirectional cosim for MousePM.v. The reference mouse's open-drain inout msclk/msdat have no
    z in Verilator's 2-state model, so a wrapper (mouse_cosim.v) splits each line like the Hardcaml
    port: force the harness-driven resolved value into the DUT and XMR-export its pull-low (req,
    ~tx[0]) as *_oe. dump_mouse plays a mouse device against Risc5.Mouse through the bidirectional
    init handshake to run, then 4 movement reports (+ve/-ve signs, buttons, overflow), recording
    the device's open-drain pull-lows per cycle; mouse.cpp replays through the wrapped RTL,
    resolving wire = ~(RTL oe | device low) — the same resolution the dumper did against th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
    [mouse.cpp, mouse_cosim.v]
2026-06-25 refactor(cosim): shared serial runner; rename fp_cosim.h -> cosim.h
    The 4 hextrace serial harnesses (ps2/rs232r/rs232t/spi) each carried a full main() duplicating
    hexval, the reset->line-loop->summary boilerplate, and (rs232t/spi) the cosim_open inline.
    Extract run_serial_cosim(unit, dut, f, reset, replay) into the shared header — it owns the reset
    call, the line loop, the value/wave/cycle tally, the stats+success lines, and the exit code —
    plus a shared hexval + Serial_mismatches struct. Each serial .cpp is now just its reset + a
    replay (the fixed-length ps2/rs232r vs drain-until-rdy rs232t/spi body) + the call: ~363 -> 260
    lines. The summary now uniformly reports all three tallies (som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
    [cosim.h, fp_adder.cpp, fp_divider.cpp, fp_multiplier.cpp, mouse.cpp, ps2.cpp, rs232r.cpp, rs232t.cpp]
2026-06-25 docs: mark Phase 6a complete (peripherals + cosim dedup)
    All Phase-6a peripheral ports (UART RS232R/RS232T, PS/2 keyboard, video, PS/2 mouse) plus the
    cosim-harness dedup have landed, each co-located-tested and cosim-verified bit-exact to its
    Verilog. Mark 6a ✅ in the §5 plan and refresh its notes: step_testbench was revisited at the
    mouse and rejected; the shared run_serial_cosim landed (fp_cosim.h -> cosim.h).
2026-06-25 feat(soc): MMIO word 1 — switches/buttons read + LED register
    Reads return {btn, sw} zero-extended; a store latches the 8-bit Lreg LED register (reset-cleared), exposed on a new [leds] output. Grow I by btn/sw, O by leds.
    The OberonStation's active-low switch pad (~nswi) is de-inverted: the SoC takes a logical active-high [sw] (matching the Nexys 4 switches), leaving the pad inversion to the Phase-7 board shim. This also keeps default-0 = all-off = the oracle's switches=0, so the boot checkpoint is unperturbed.
    Refactor the MMIO read mux from nested mux2s into a single iowadr-indexed mux with one labelled slot per word, so later peripheral steps fill in a placeholder each.
    Verified: dun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
2026-06-25 feat(soc): MMIO words 8/9 — GPIO data + tri-state registers
    Two 8-bit registers: gpout (drive value, word 8 write) and gpoc (direction / tri-state control, word 9 write). gpoc is reset-cleared; gpout is not, faithful to the RTL (a pin powers up as input). Word 8 reads the pin inputs (gpin), word 9 reads gpoc back.
    The bidirectional gpio[7:0] pad is split as in the mouse port (Hardcaml has no inout): input gpio_in (resolved pad value) and outputs gpio_out (= gpout) / gpio_oe (= gpoc, active-high output-enable). The Phase-7 board shim reassembles the IOBUFs (.T(~gpio_oe)).
    No oracle reference (the emulator models clipboard at words 10/11 and no GPIO at 8/9), but boot never touches GPIO and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
2026-06-25 feat(soc): video DMA / stallX path — VID wired with cycle-stealing
    Instantiate the video controller (Vid) and wire RISC5Top's framebuffer DMA: vid.req drives the core's stall_x, the SRAM address is arbitrated sram_adr = vidreq ? vidadr<<2 : adr[19:0], and the framebuffer word ram.rdata feeds vid.viddata. Scan-out (hsync/vsync/rgb) and the pixel clock pclk are now SoC ports; inv = sw[7] (RISC5Top ~nswi[7]).
    The single-port video cycle-steal: every 32 px VID requests a word, freezing the core one cycle (PC/IR held) and steering the shared SRAM port to the framebuffer. Safe because RISC5.v gates wr/rd/ben with ~stallX (our core mirrors it), so wr => ~vidreq and a store can never be misrouted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
2026-06-25 feat(soc): MMIO words 2/3 — UART RS232R/RS232T + bitrate
    Word 2 read returns the received byte (dataRx) and pulses doneRx; word 2 write starts a transmit (startTx, dataTx = outbus[7:0]). Word 3 read = {rdyTx, rdyRx}; word 3 write sets the 1-bit bitrate select (0=19200, 1=115200), feeding both units' fsel. New ports rxd (in) / txd (out).
    Also rename the SPI's looked-up shift register shreg -> spi_shreg: once composed into the SoC, RS232R/RS232T (and later PS/2) also name a register shreg, so the boot checkpoint's lookup_reg_by_name shreg became ambiguous and resolved to an idle UART register, desyncing the SD bridge (boot stuck reading sectors). The qualified name keeps the cross-module lo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
2026-06-25 feat(soc): MMIO words 6/7 — PS/2 keyboard + mouse
    Word 6 read = {3'b0, rdyKbd, dataMs} (mouse state in [27:0], keyboard-ready at bit 28); word 7 read = {24'b0, dataKbd} and pulses doneKbd (pops the keyboard FIFO). New keyboard inputs ps2c/ps2d; the mouse's open-drain msclk/msdat split mouse-style into resolved-line inputs and drive-low msclk_oe/msdat_oe outputs. This completes RISC5Top's MMIO map (words 0-9); words 10-15 read 0.
    No new name collision — the Step-4 spi_shreg rename already covered the shift-register/run names PS/2 and the mouse reuse.
    Verified: @check clean; new keyboard inline test drives a device->host PS/2 frame and reads scancode 0x1C from word 7, with word 6 = 0x100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
2026-06-25 fix(core): qualify ALU ADD/SUB flags with ~p
    RISC5.v sets C/OV only for register ADD/SUB (ADD = ~p & (op==8), SUB =
    ~p & (op==9)); our ALU computed the flags from op alone, so a branch or
    memory instruction (p=1) whose op field IR[19:16] is coincidentally 8/9
    spuriously recomputed a carry and clobbered C. Latent until a *stalled*
    conditional branch re-evaluates its condition on the stall cycle with the
    corrupted flag — which is exactly what aborted the boot at ~17.3M cycles
    (BLR CC,R12 = 0xDA08281C, op field 8, on R0=2: C should stay 1 / in
    range, but got clobbered to 0 -> spurious array-bounds trap). Add p to
    the ALU and qualify is_add/is_sub; the result mux stays op-only like
    aluRes (a b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
2026-06-25 test(soc): boot-stream core RTL co-sim + Phase 6b visual golden
    Add the boot-stream RTL co-sim — the CPU core's first cycle-level
    fidelity check vs RISC5.v (AGENT.md §6 layer 3, extended to the whole
    core over a real boot; its only such check before the Phase-8 proof). It
    found and verified the ~p flag-leak fix:
    - test/dump_core_trace.ml boots the SoC and records the core's per-cycle
    I/O to a trace; test/cosim/risc5.cpp Verilates RISC5.v + its 8
    submodules (ram16x1d.v supplies the RAM16X1D primitive Registers.v
    infers, like vid_cosim.v's DCM stub) and replays it, reporting the
    first cycle our outputs diverge from the spec. Both cores start from
    the same reset state and stay in l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
    [ram16x1d.v, risc5.cpp]
2026-06-25 docs: mark Phase 6b complete
    The SoC top (full RISC5Top MMIO map + the video DMA / stallX path) and the
    visual golden are done — the SoC boots byte-identical to the oracle's idle
    Oberon desktop. Records the core bug the boot-stream RTL co-sim caught and
    fixed (ADD/SUB flags missing ~p) and the new @core_cosim / @visual_golden
    opt-in checks.
2026-06-25 test(cosim): self-healing verilator build in run.sh / run-core.sh
    The cosim runners reused $work/obj_dir without cleaning, so a stale or
    partial build (from an interrupted/flaky first verilate) poisoned every
    retry; and `... | tail -N` masked the real error behind verilator's
    wrapper note. Verilate to a log instead, and on any failure nuke obj_dir
    and retry once clean (recovers from stale state or an intermittent flake);
    a second failure surfaces the full log and exits nonzero.
2026-06-27 docs: note hardcaml_of_verilog install via forked jsonaf pin
    §9: replace the stale "hardcaml_of_verilog blocked" note with the actual
    one-line install recipe — the preview jsonaf v0.18~preview.130.91+190 tarball
    annotates its Faraday serializers @@ portable (unsatisfiable; no portable
    faraday exists), so it won't build. Our fork drops those 4 annotations
    (parse-only); pin it + install:
    opam pin add jsonaf.v0.18~preview.130.91+190 \
    'git+https://github.com/zxygentoo/jsonaf.git#528a015' --yes
    opam install hardcaml_of_verilog hardcaml_verify --yes
    (+ yosys on PATH at runtime). §6: soften the matching "unbuildable on the
    preview" cross-reference. Reproducible-pinning apparatus (loc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
2026-06-27 test(formal): Phase-8 logic-equivalence harness (left_shifter ≡ LeftShifter.v)
    The "Formal" verification layer (AGENT.md §6 layer 6) — the exhaustive
    counterpart to test/cosim. Where the cosim *simulates* a unit against its
    reference .v and samples, this *proves* equivalence over every input:
    hardcaml_of_verilog imports the .v to a Hardcaml.Circuit.t (yosys), and
    hardcaml_verify's Sec SAT-checks it against ours (z3). Unsat = equivalent.
    First result: our Risc5.Left_shifter (log_shift, radix-2) is proven to compute
    the identical function as Wirth's LeftShifter.v (radix-4 mux tree) — two
    structurally different netlists, one theorem. Negative control (srl instead of
    sll) yields a c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
2026-06-27 test(formal): RightShifter equivalence; defer ALU to in-situ core import
    Add right_shifter to the formal harness: Risc5.Right_shifter (ASR/ROR barrel
    shift) proven ≡ RightShifter.v by z3 (Unsat). Both combinational shifters are
    now formally verified. Also expose Right_shifter in the risc5 curated index.
    ALU — decided to defer (option B). There is no standalone ALU.v: aluRes is
    inline in RISC5.v (lines 106-125) tangled with the shift/MUL/DIV/FP unit
    outputs, and our lib/alu.ml is a refactored grouping (folds C0→c1, zeroes the
    other units' op slots, emits only C/OV), not an RTL slice. A formal check would
    mean authoring a reference alu_ref.v, which crosses §2's "the Verilog is the
    spec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
2026-06-27 test(formal): sequential equivalence via yosys equiv_induct (Multiplier ≡ Multiplier.v)
    Add the sequential mode to test/formal, the counterpart to the combinational
    Sec/z3 path. Where Sec pairs registers by name and the hardcaml_of_verilog
    import mangles/regroups them, this emits our circuit to Verilog (Rtl) and proves
    equivalence inside yosys: equiv_make pairs flip-flops by name, equiv_induct
    proves the step by unbounded temporal induction, equiv_status -assert checks
    every $equiv closed. Needs only yosys (built-in SAT) — no import, no z3.
    Multiplier proven ≡ Multiplier.v (induction closed, 71/71 $equiv). The make-or-
    break is FF pairing: registers named S/P in lib/multiplier.ml so e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
2026-06-27 test(formal): sequential equivalence Divider ≡ Divider.v (yosys equiv_induct)
    The Multiplier's structural twin, so the same sequential path: name the two
    registers S/RQ to match Divider.v so yosys equiv_make pairs the flip-flops by
    name, emit our Verilog, prove the step by equiv_induct. The extra combinational
    output logic (floored sign-correction) is fan-out off RQ that equiv_simple
    discharges once the FFs pair, so only S/RQ needed naming.
    - lib/divider.ml: name the S/RQ registers (the module predated the harness)
    - lib/risc5.ml: surface Divider in the curated index (first external consumer)
    - test/formal/test_formal.ml: divider thunk + sequential row
    - docs: README + AGENT.md status lin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
2026-06-27 test(formal): sequential equivalence FPAdder ≡ FPAdder.v (yosys equiv_induct)
    The first sequential proof where the combinational cones differ structurally
    from the RTL: our denormalize/post-normalize are log_shift + sign-fill
    arithmetic shifts, vs FPAdder.v's radix-4 mux trees. yosys's SAT proves them
    equivalent for all inputs (the obligation z3 discharged for the standalone
    shifters), closing every $equiv point — exhaustive confirmation of what the
    cosim/fp_vectors only sampled.
    - lib/fp_adder.ml: name the five pipeline FFs State/x3/y3/Sum/t3 to match the .v
    - test/formal/test_formal.ml: fp_adder thunk + sequential row
    - docs: README + AGENT.md status lines (FPAdder proven; FPMul/FPDiv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
2026-06-27 test(formal): sequential equivalence FPMultiplier/FPDivider ≡ their .v (yosys equiv_induct)
    Completes the standalone-.v datapath proofs: every unit with its own reference
    .v is now proven equivalent — both shifters via z3, and MUL/DIV/FPAdder plus
    these two via yosys. Both are transliterated (no log_shift), so the SAT closes
    as easily as the integer MUL/DIV.
    - lib/fp_multiplier.ml: name the S/P flip-flops to match FPMultiplier.v
    - lib/fp_divider.ml: name S, and R/Q on the reg output (not the forward-declared
    wire), to match FPDivider.v
    - test/formal/test_formal.ml: fp_multiplier + fp_divider thunks + sequential rows
    - docs: README + AGENT.md (every standalone-.v unit proven; ALU + cor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
2026-06-27 test(formal): register file ≡ behavioural spec (equiv_induct over registers_spec.v)
    The register file is the one unit where structural equivalence to the RTL is
    both intractable and the wrong notion. Wirth's Registers.v builds the triple-port
    file from 64 duplicated, bit-sliced RAM16X1D primitives — a synthesis idiom whose
    state (1024 bits) is structurally incongruent with our single 16x32 array (512
    bits): equiv_make has nothing to pair, and a memory miter isn't inductive on
    outputs alone (an unread location can differ in an unreachable state — only a
    shallow bounded check proved tractable). So we prove our Registers against the
    behavioural CONTRACT it implements (16x32, 3 async reads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
    [registers_spec.v]
2026-06-27 refactor(core): injectable Units seam for the in-situ formal proof
    The 8 submodule constructors RISC5.v instantiates (2 shifters + 5 iterative +
    the register file) become an injectable Units.t record; the ALU and all glue
    stay inline (aluRes is inline in RISC5.v, so it is proven as part of the glue,
    not black-boxed). create is unchanged (= create_with_units ~units:Units.default),
    so sim / lockstep / boot are byte-identical — verified: @check clean, CPU
    lockstep 50k x 4 green. create_with_units ~units is the seam the Phase-8 in-situ
    core proof uses to swap the real units for black-box Instantiation stubs and
    prove the glue with the units assumed-equivalent (each proven separately, §6).
    Al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
2026-06-27 test(formal): in-situ core glue ≡ RISC5.v (assume-guarantee, 8 units black-boxed)
    Phase 8's last and hardest target: prove the whole core's glue — decode, the
    inline ALU (aluRes, which has no standalone .v), the control unit, the flag logic,
    and the 13 state registers — equivalent to RISC5.v, with the 8 submodules
    black-boxed and assumed-equivalent (sound: each is proven separately — 7 vs their
    .v, the register file vs its behavioural contract).
    The flow (Yosys_equiv.check_core): rename our registers to RISC5.v's names so
    equiv_make pairs the top flip-flops; equiv_make also MERGES the matched black-box
    cells, checking their inputs via the $equiv on the named nets; cutpoint -blackbox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
    [core_stubs.v]
2026-06-27 docs(formal): record Tier 1/2 peripheral formal goals; SoC out of scope
    Phase 8's datapath + core layer is closed; the next goal is extending the same
    yosys equiv_induct path to the faithful-.v peripherals — the exhaustive upgrade
    of their existing Phase-6a Verilator cosim:
    - Tier 1 (clean, single-clock, a `sequential` row each): RS232R, RS232T, SPI, PS2
    (work = match register names to the RTL, as the core does via register_renames)
    - Tier 2 (one wrinkle each): Mouse (MousePM.v's inout msclk/msdat vs our oe+in
    split → a wire-AND shim), VID (two-clock ⇒ multiclock equiv, plus a deliberate
    CDC departure from VID60.v ⇒ prove around the CDC, not bit-exact there)
    Out of scope: the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
2026-06-27 test(formal): Tier-1 peripherals ≡ their .v (RS232R/T, SPI, PS2; yosys equiv_induct)
    Extend the Phase-8 sequential formal recipe from the datapath+core to the four
    clean single-clock peripherals — the exhaustive upgrade of their Phase-6a
    Verilator cosim. 13 formal checks, all proven.
    - Yosys_equiv.check gains a per-row ~renames list (mirroring check_core's
    register_renames), factored into a shared rename_block: the lib keeps its
    waveform/SoC-namespaced register names and we pair them to the RTL's in yosys.
    - RS232T: names already match (run/tick/bitcnt/shreg), no renames. 28 cells.
    - RS232R: q0->Q0, q1->Q1; stat/bitcnt newly named in lib (every reg must be
    named for equiv_make to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
2026-06-27 test(formal): Mouse ≡ MousePM.v via open-drain inout shim (yosys equiv_induct)
    Tier-2 Mouse: MouseP has bidirectional open-drain `inout msclk, msdat`; our
    port (lib/mouse.ml) splits each into a `*_oe` drive output + a resolved-value
    input. Two checked-in shims (mouse_shim.v) wrap BOTH sides into one explicit
    interface and the shimmed pair is proven equivalent (Yosys_equiv.check_shim /
    run_mouse, a one-off runner like run_core).
    Key points:
    - The external read MUST be a free primary input. A first single-shim attempt
    (ours re-presenting MouseP's inout) passed but was VACUOUS — with no external
    driver yosys ties the inout read to 0, the FSM constant-folds, and the proof
    compares 0==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
    [mouse_shim.v]
2026-06-27 fix(vid): metastability-safe toggle CDC synchroniser; prove raster+pixels ≡ VID60.v
    The Phase-8 formal layer flagged VID's framebuffer-fetch CDC as the one place our
    port can't pair with VID60.v: our pclk-domain `caught` one-shot vs the RTL's
    async-set `req1`. That "correct failure" was not academic — on the Nexys 4
    (Phase 7) it surfaced as a real metastability bug: `caught` was sampled directly
    in the clk domain with no synchroniser (plus a clk->pclk feedback), sim-clean but
    timing-marginal on silicon, producing horizontal flicker on the booted desktop.
    Fix (lib/vid.ml): replace `caught`+feedback with the textbook metastability-safe
    crossing — a TOGGLE pulse-synchroniser. `req0` togg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
    [vid_stubs.v]
2026-06-27 test(formal): prove VID fetch-CDC invariant — no-loss/no-spurious, all phases, UNBOUNDED
    Closes the one gap check_vid cuts: the framebuffer-fetch CDC. That CDC is *not* a
    cycle-equivalence (our toggle synchroniser deliberately departs from VID60.v's
    async-set req1), so equiv can't touch it — but its protocol is provable, and for
    ALL reachable states.
    - Extract lib/vid.ml's synchroniser into a reusable primitive Vid.pulse_sync
    (inline, no submodule → emitted vid byte-identical → check_vid + sim unchanged).
    - New property-proof path Yosys_equiv.check_property: emit gate → clk2fflogic →
    write_smt2 → yosys-smtbmc -i -s z3 (k-induction; the engine SymbiYosys wraps, no
    sby nee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
2026-06-27 test(cosim): accommodate VID's deliberate req CDC departure
    The metastability-safe toggle synchroniser (753ed27) makes VID's fetch request
    [req] fire ~2 clk later than VID60.v's async-set req1 — a deliberate departure,
    not a cycle-equivalence (the equiv proof cuts req; vid_invariant proves its
    protocol). The cosim demanded req cycle-exactness, so it (correctly) flagged the
    change. Update it to match how the equiv/formal layers treat req:
    - vid.cpp: drop req from the per-tick cycle-exact compare; instead count req
    pulses on both sides and require them equal (±1 for the one fetch the
    synchroniser may hold in flight at the trace boundary). Keep vidadr/hsync/vsync/
    RGB cycle-exact.
    - d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
    [vid.cpp]
2026-06-28 docs(plan): update phased-plan progress (Phase 7 board bring-up; Phase 8 in-scope ✅)
    - Phase 7 → in progress (🚧): the Phase-6 design ports nearly unchanged onto a
    Nexys 4 and boots Oberon to the idle desktop from SD on real silicon. Records
    the horizontal-flicker bug the Phase-8 formal layer pinpointed (VID's
    framebuffer-fetch CDC — the one non-cycle-equivalent spot), its metastability-
    safe toggle-synchroniser fix, and the pending .xdc CDC constraints + re-test.
    - Phase 8 → in-scope ✅: every datapath unit, the core glue, and all faithful
    peripherals proven (16 @formal checks); only the board-specific SoC top is out
    of scope.
    - §6 (verification pyramid): extend the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
2026-06-28 test(cosim): self-contained test/ layout + core_cosim reset-boundary fix
    Relocation (make the opt-in cosim/formal suites self-contained under test/):
    - Move the fetched reference RTL _po/ -> test/_po/, and hoist the shared
    fetch-rtl.sh + rtl-sources.txt up to test/ (used by both cosim and formal;
    drops formal's ../cosim/ cross-reach).
    - Move all test scratch (Verilator obj_dirs, dumped traces, the downloaded
    zip, yosys/z3 intermediates) into in-repo test/_work/ instead of /tmp or
    $CLAUDE_JOB_DIR. No env-var work-dir config.
    - Both test/_po and test/_work are git-ignored and marked (data_only_dirs) so
    dune skips them.
    - Update every path reference: fetch-rtl.sh, run.sh, run-core.sh,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
    [fp_adder.cpp, fp_divider.cpp, fp_multiplier.cpp, mouse.cpp, mouse_cosim.v, ps2.cpp, risc5.cpp, rs232r.cpp]
2026-06-28 test(cosim): parallel OCaml runner (cosim_run) with PASS/FAIL summary
    Replace run.sh's serial, abort-on-first-failure loop with a proper runner:
    - cosim_run.ml: a typed `units` list (a Stimulus/Core variant, so the CPU core's
    boot-replay shape fits alongside the stimulus units), a fork-per-unit + wait
    pool (default one job per core), per-unit logs, and a PASS/FAIL summary that
    continues past failures and exits nonzero iff any failed. @cosim runs the exe
    directly; `dune exec test/cosim/cosim_run.exe -- <unit> [jobs]` is the CLI.
    fetch-rtl.sh stays bash (toolchain-free on a fresh clone); run.sh + run-core.sh
    are removed.
    - Naming: dump_<unit>.ml -> <unit>_dump.ml, risc5.cpp -> co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
    [core.cpp, cosim.h, fp_adder.cpp, fp_divider.cpp, fp_multiplier.cpp, mouse.cpp, ps2.cpp, rs232r.cpp]
2026-06-28 test(cosim): merge rs232 tx/rx dumpers into one rs232_dump
    rs232t_dump.ml + rs232r_dump.ml shared their test-vector driver (8 corner bytes x
    both baud rates + an rng-0x232 fast/slow fuzz pass) and reset/emit shape, differing
    only in the per-frame protocol (TX start/rdy handshake vs RX baud-timed waveform).
    Fold them into one rs232_dump.ml selected by argv (rs232t|rs232r, like fp_dump's
    unit arg): a shared `drive` runs the vectors; `tx`/`rx` keep their own `frame`.
    cosim_run passes the unit name to rs232_dump (the second shared dumper after
    fp_dump). The rs232t.cpp / rs232r.cpp replay harnesses are unchanged.
    (core_dump.ml stays in test/ as-is per review — it's the oracle+sd_bridge-coupled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
    [rs232r.cpp, rs232t.cpp]
2026-06-28 test(formal): parallel OCaml runner via shared Fork_pool; drop run.sh
    Increment 3 — give formal the same shape as cosim, and factor the now-shared pool.
    - New shared library fork_pool (test/fork_pool.{ml,mli}): a bounded forked-worker
    pool with a PASS/FAIL summary, used by BOTH runners. fork (not Domains) is the
    right tool here — the jobs are subprocess-bound (verilator/yosys/z3 already run
    parallel at the OS level), and fork gives each job process isolation (the formal
    checks build Hardcaml + run hardcaml_verify in-process, not domain-safe) plus
    clean per-job log capture via per-process stdout/stderr.
    - cosim_run: drop its inline pool/summary, call Fork_pool.run.
    - test_for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
2026-06-28 test(cosim): cap core_cosim at ~2M cycles (boot spot-check, not full boot)
    core_cosim is the cycle-fidelity spot-check (our core == RISC5.v cycle-by-cycle);
    boot *correctness* is already covered by boot_checkpoint + visual_golden, so it
    needn't replay the whole boot. Drop the default CAP from 25M to 2M cycles: reset +
    ROM init + a solid run of the SD-load driver — a real branch/ALU/load-store-stall/
    byte-mem stream that exercises the core's decode/control/stall/flags machinery.
    Raise CAP to replay deeper (handoff ~8M, inner core 8M+).
    Trace 425MB -> 33MB, capture ~90s -> ~10s; @cosim's core long pole drops from
    ~148s to ~17s fresh (~1s cached). Verified NO DIVERGENCE over 2M cycles; @cosi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
2026-06-28 test: suppress redundant per-job live lines when stdout isn't a TTY
    Fork_pool printed a live [PASS]/[FAIL] line as each job finished AND a summary
    table at the end. Under `dune build` the action's stdout is captured and flushed
    all at once, so the live lines landed right next to the summary — every job
    listed twice. Gate the live lines on Unix.isatty: real-time progress on a
    terminal (direct run / dune exec), just the summary when captured (dune build).
    Also drop the intro line's trailing colon so it reads cleanly without the list.
    Shared pool, so it fixes both @cosim and @formal.
2026-06-28 test: tidy cosim/formal runners; refactor core_dump into named helpers
    Both opt-in runners had two top-level `let ()`s — a standalone
    find-root-and-chdir statement plus main. Fold the cd into a
    `cd_to_repo_root` helper called once at the top of the single remaining
    `let ()`. In cosim_run this drops the standalone `repo_root` value; `abs`
    now reads `Sys.getcwd ()` (cwd is the repo root after the helper runs).
    Break core_dump's ~230-line `let ()` into named pieces, each carrying the
    rationale comment for the code it owns: project_root/copy_to_temp/getenv_int
    plumbing, a `config` record + read_config, a `probes` record + lookup_probes,
    put_u32/encode_record, the windowed dump_state, a `resul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
2026-06-28 test(cosim): drop dumpers' informational count summaries
    The dump -> verilate -> cross-check pipeline reports its own verdict and the
    forked-worker runner aggregates PASS/FAIL, so each dumper's trailing
    `eprintf "<unit>: N stimuli ..."` stderr line was redundant. Drop the six
    summaries and the counters that fed them (each became write-only once the
    line went). vid_dump's `ticks` stays — it's the loop bound, not just a tally
    — and rs232_dump's `usage:` error stays.
    Pure output trim: every dumper's stdout (the port.txt data the harness
    consumes) is byte-identical to before across all nine streams, and the ps2
    cross-check still reports bit-exact AND cycle-exact vs PS2.v.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
2026-06-28 test(cosim): drop the per-unit `=== unit ===` banner
    The forked-worker runner already prints a PASS/FAIL summary and each unit's
    run.log is named by unit, so the banner only restated the name. Drop it from
    run_stimulus/run_core; the `[1/3]/[2/3]/[3/3]` stage lines stay (they tell you
    which stage failed and already carry the unit name). Also retarget the README's
    "formal-equivalence proof" caption at test/formal (the layer is now primarily
    yosys equiv_induct, not just hardcaml_verify).
    [core_stubs.v, mouse_shim.v, registers_spec.v, vid_invariant.v, vid_stubs.v]
2026-06-28 test(formal): template-driven proof harness — one run_proof + proofs/*.ys.template
    Collapse the five bespoke check_*/check functions in Yosys_equiv into a single
    generic driver, run_proof, applied to a checked-in .ys.template per proof under
    test/formal/proofs/. run_proof emits our circuit to Verilog, substitutes
    {placeholder} -> value into the template, writes the concrete script (still
    inspectable + runnable), runs yosys, and maps the exit; the property proof
    (vid_invariant) adds a yosys-smtbmc step via ~smtbmc. A leftover {...} after
    substitution raises (template/subst mismatch).
    The proof tactic now lives as a readable artifact (the template) rather than a
    string built in OCaml; the b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
2026-06-28 docs(lib): doc pass on *.mli — readable module comments + complete I/O field docs
    Restructure soc.mli's single dense paragraph into scannable {1} sections
    (address decode / video-timer-interrupts / per-word MMIO map / parameters)
    and add the I/O field comments it lacked entirely.
    Convert the peripheral field comments from plain (* *) to doc (** *) comments
    (spi, rs232r, rs232t, ps2, mouse, vid) so odoc/merlin actually attach them,
    filling the gaps each had (clock, spi's data_tx/miso/data_rx).
    Add the missing field comments to prom (adr/data) and sram (all fields), and a
    short timing note to the previously-bare `clock` field on the multi-cycle
    datapath units (multiplier, divider, fp_*) an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
2026-06-28 refactor(test): rename core_dump → risc_core_dump
    "core_dump" read like an OS coredump. Rename the boot-stream CPU-core
    co-sim capture program and update its build wiring (test/dune executable,
    @cosim deps, cosim_run exe paths), its own diagnostic strings, and the
    cosim docs/comments (core.cpp, README).
    The CPU-core references that aren't the dump program — core.cpp,
    core_boot.trace, the cosim/core work dir — are unchanged; they name the
    core, not a dump.
    All gates green: dune fmt / @check / runtest, @cosim (10/10, incl. a
    fresh core capture through the renamed exe), @boot_checkpoint,
    @formal (16/16).
2026-06-29 docs(phase7): lock board layout — boards/nexys-4/
    Phase 7 kickoff: record the board-layer file layout in AGENT.md §3 (a
    one-line locator) and §9 (the repo-layout tree + a "Board layer layout"
    convention paragraph), so it is fixed before any board code lands.
    - boards/<target>/ — synthesizable, vendor-free Hardcaml (library
    nexys4_board, depends on risc5 one-way → lib/ stays board-independent,
    enforced by the compiler, not convention).
    - the only vendor primitives (MMCM/IOBUF/POR) live in the target's
    hand-written nexys4_top.v.
    - generated/build artifacts hoist to boards/_generated/<target>/ and
    boards/_build/<target>/ (two all-boards .gitignore entries), so eac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
2026-06-29 feat(phase7): ?ce clock-enable seam for PSRAM memory waits
    RISC5.v assumes single-cycle 32-bit async SRAM; the Nexys 4 has 16-bit
    ~70ns PSRAM, so a word fetch costs several clocks. The existing stall path
    cannot carry a fetch wait — it collapses pcmux→PC, redirecting adr off the
    fetch target. So add an out-of-band clock-enable that freezes all state
    while adr/pcmux hold steady, making the slow memory look single-cycle to
    the core it was designed for.
    - 5 iterative units (mul/div/fp_*): create gains ?(ce = vdd); a local
    reg/reg_fb shadow bakes in ~enable:ce. Gating their counters is required,
    not optional — without it a unit re-runs forever during the post-op
    fetch-wait (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
2026-06-29 feat(phase7): scaffold boards/nexys-4 + Cellram PSRAM controller & sim model
    Establish the board layer (library nexys4_board) and its first module — the
    synthesizable PSRAM memory controller + CPU/video arbiter that bridges the
    Nexys 4's 16-bit ~70ns async cellular PSRAM to the 32-bit single-cycle word
    interface the core and video expect, and drives the core's ce.
    - boards/nexys-4/{dune,cellram,cellram_model}: nexys4_board depends on risc5
    one-way (so lib/ stays board-independent, enforced by the compiler); root
    (dirs) += boards; .gitignore += /boards/_generated/ + /boards/_build/.
    - cellram: a small FSM over one PSRAM port. A 32-bit word = two 16-bit halfword
    phases; ce =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
2026-06-29 feat(phase7): Soc_board + board boot checkpoint — boots the real disk through PSRAM in sim
    The board variant of the SoC and its functional proof. Soc_board wires the
    ce-gated core + Cellram (PSRAM controller/arbiter) + the peripherals + video,
    and boots the real Oberon disk through the PSRAM path to the OS handoff,
    byte-identical to the oracle. This closes the sim half of M1 — the whole board
    memory path is verified before Vivado.
    - lib/vid: a ?viddata_valid seam (default = req) so the board latches the
    framebuffer word on Cellram's vid_ack (multi-cycle read) rather than on req
    (single-cycle BRAM). Identity-default; @formal / @cosim / @visual_golden all
    byte-identical.
    -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
2026-06-29 feat(phase7): Nexys 4 vendor shim + Vivado flow — boots Oberon to the desktop on real HW
    The board-shim layer that wraps the synthesizable Soc_board with the vendor
    primitives and builds the bitstream. On a real Nexys 4 this boots Project Oberon
    from SD to the desktop; the horizontal flicker is largely resolved.
    - boards/nexys-4/nexys4_top.v: the hand-written top — MMCM (100→25/65 MHz),
    power-on reset, 16 IOBUFs for the bidirectional PSRAM data bus, the async-SRAM
    tie-offs, the soc_board instantiation, and 1bpp-mono VGA onto the 12-bit DAC.
    PS/2 idled (mouse-first wiring is the next step).
    - boards/nexys-4/nexys4.xdc: pin constraints (from the Digilent master) + the VI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
    [nexys4.xdc, nexys4_top.v]
2026-06-29 feat(phase7): wire the PS/2 mouse — faithful MousePM.v works on real HW
    Wire the single PS/2 port (via the board's USB-HID PIC) to the mouse and
    confirm on hardware: develop's faithful Mouse (the cosim/formal-proven
    MousePM.v port) tracks the cursor and executes commands (middle-click
    Hilbert.Draw from System.Tool) with a known-good mouse — no init workarounds.
    The scratch's "PIC handshake is broken" was just incompatible test mice; a
    mouse that passes the Digilent OOB demo works as-is.
    - soc_board: route mouse.out to a new mouse_dbg output (instrumentation
    only — the MMIO-word-6 path the CPU reads is untouched).
    - nexys4_top.v: two open-drain IOBUFs on PS2Clk/PS2Data, wire th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
    [nexys4.xdc, nexys4_top.v]
2026-06-29 fix(phase7): preempt CPU reads in the Cellram arbiter — kills the video flicker
    The framebuffer fetch has a hard ~477 ns raster deadline (Vid's req0->xfer).
    At read_cycles=2 the worst case — a fetch arriving just after a CPU access
    seized the PSRAM port, waiting the whole access out — sat right at the cliff:
    the desktop flickered, and under a live cursor's redraw load it occasionally
    overran into a corrupt read -> trap -> black/freeze.
    Make video priority preemptive over CPU *reads*: a video request mid-CPU-read
    aborts the read and goes at once; the core is frozen on ce and never saw it
    retire, so it re-arbitrates and restarts transparently (reads are idempotent;
    only a few cycles was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
2026-06-29 fix(phase7): extend power-on reset to ~2.7s — mouse comes up without a manual reset
    The Mouse sends its PS/2 init handshake once and latches `run`; the board's
    USB-HID PIC isn't ready that early (post-config line-settle on a JTAG reload;
    USB mouse enumeration on a cold boot), so the single init landed before the PIC
    was up and streaming never started — the cursor stayed dead until a btnCpuReset
    re-ran the init late, when the PIC was ready.
    Simplest fix: widen the POR counter 16 -> 26 bits (~2.6 ms -> ~2.7 s) so the
    whole SoC (mouse included) stays in reset until the PIC is up; the mouse's
    one-shot init then lands clean. Automates the post-config reset the bring-up
    needed. Dwarfed by Obe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
    [nexys4_top.v]
2026-06-29 chore(phase7): drop the hardcoded ox switch from gen_verilog.sh
    The script pinned `opam env --switch 5.2.0+ox`, which is too restrictive —
    it forces one specific switch name. Use the active/default switch instead;
    keeping that switch working (Hardcaml v0.18~preview, AGENT.md §9) is the
    user's responsibility.
2026-06-29 test(phase7): board-layer test coverage + converge read/write_cycles on 2
    Co-located tests for boards/nexys-4 (mirrors lib/soc.ml's pattern — hand-
    assembled programs on the interpreter, no oracle dep, so the board lib stays
    oracle-free per AGENT.md §3/§6):
    - soc_board.ml (had 0 vs lib/soc.ml's 9): fetch/store/load round-trip through
    the Cellram PSRAM path; the free-running ms timer ticking on clocks while the
    CPU is wait-stated (not ce-gated); MMIO word-1 LED latch + {btn,sw} read.
    - cellram.ml: wait-state latency (read = 2*read_cycles, write = 2*write_cycles,
    each independent of the other, incl. asymmetric counts); an asymmetric
    round-trip qcheck; video does NOT preempt an in-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
2026-06-29 fix(phase7): 2-group video prefetch in Vid — kills EO PSRAM-contention flicker
    EO's residual screen-left flicker was the framebuffer fetch missing its
    ~480 ns raster deadline under PSRAM contention: each line's first fetch
    (issued right after hblank) races whatever the CPU seized during the idle
    hblank, and an unpreemptable CPU write eats the ~155 ns margin the Cellram
    read-preempt left. PO's lighter idle loop stayed inside it; EO's didn't.
    Issue the fetch one group early into a ping-pong double-buffer, ~doubling
    the deadline to ~970 ns (each buffer is live for two group-times, so a
    slow/contended fetch is absorbed). A deeper shift-pipe would NOT help —
    each xfer-gated stage stays a 31-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
2026-06-30 test(phase7): VID Phase-8 equiv — exclude the 2nd departure (prefetch vidadr)
    Follow-up to the 2-group prefetch (0a2bfd7), which flagged the formal proof
    needed updating for the new departure from VID60.v.
    The prefetch is a 2nd deliberate departure (after the CDC): our look-ahead
    vidadr leads VID60.v's by one group, and the ping-pong banks feed pixbuf
    through a read mux instead of the RTL's single vidbuf register. So the
    whole-VID equiv can't close at the fetch front-end — prove AROUND it:
    - lib/vid.ml: rename the ping-pong read mux cur_word -> vidbuf (named, so the
    emitted Verilog carries the net). It plays the exact role of VID60.v's vidbuf
    (the word pixbuf loads), so the equiv p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
2026-06-30 test(phase7): VID @cosim — identity-echo framebuffer for the prefetch departure
    Follow-up to the 2-group prefetch (0a2bfd7): the @cosim vid unit failed
    (RTL adr=X vs PORT adr=X+1 every tick) because the prefetch makes our vidadr
    lead VID60.v's by one column, and our displayed word is sampled a full group
    earlier — more than the <=1-group slack the old time-indexed per-group viddata
    model could absorb (that trick only covered the req CDC's sampling jitter).
    Switch both sides to an identity-echo framebuffer (mem[a] = a), each reading its
    OWN vidadr: the dumper drives our viddata = our vidadr; the harness drives
    VID60.v's viddata = VID60.v's own vidadr. vidadr is stable across a 32-px grou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
    [vid.cpp]
2026-06-30 test(phase8): formalize VID prefetch delivery by decomposition
    The `vid` equiv proof cuts `vidbuf` and excludes the prefetch's `vidadr`
    departure, so it proves the display is correct *given the right word*. This
    closes the remaining gap — that the 2-group look-ahead actually DELIVERS the
    right word (`Org+{~v,c}`) — by decomposition, since a monolithic all-phases
    k-induction does not converge (col 0 is cross-line, the frame's first col 0
    cross-frame: the prototype is true on inspection but k=96..140 fail at the
    inductive step and k=256 runs >6 min without closing).
    Decomposition: delivery <= addressing [vid_addr] AND timing [vid_invariant]
    AND a ping-pong margin, glued by a reviewed comp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
2026-06-30 feat(nexys-4): flash.tcl — write the bitstream to QSPI for persistent boot
    program.tcl only does a volatile SRAM load (lost on power-cycle). flash.tcl
    writes oberon.bit to the board's S25FL128S config flash (16 MB QSPI) so the
    board boots Oberon on power-up with no JTAG load.
    Generates oberon.mcs (SPIx1 — the as-built bitstream has no SPI-boot config
    properties, so x1 is the safe default; ~1 s slower power-up config than x4),
    then runs Vivado's cfgmem flow (helper bitstream -> erase -> program -> verify).
    Resolves the cfgmem part dynamically and errors clearly if absent.
    Prereq for boot-from-flash: MODE jumper (JP1) -> QSPI. The flash WRITE goes
    over JTAG and is mode-independent; non-b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
2026-06-30 Close Phase 7: board verified on silicon; honest CDC constraint note
    Flip the Phase-7 row to done — the Nexys 4 boots Project Oberon and
    Embedded Oberon from SD on real hardware, and the horizontal video
    flicker (the VID framebuffer-fetch CDC the Phase-8 formal layer had
    pinpointed) is confirmed gone on silicon. Post-route timing closes:
    WNS 9.389 ns (pixel) / 20.992 ns (clk25), all constraints met.
    CDC constraints: keep set_clock_groups -asynchronous + ASYNC_REG on
    sync0/1/2 (the hardware-proven config). A set_max_delay -datapath_only
    on the req_toggle->sync0 hop was tried and reverted: verified inert
    (clock_groups outranks set_max_delay in Vivado, so it binds zero
    endpoints -> routed pa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
    [nexys4.xdc]
2026-06-30 Phase-9 scratch: retune the board for a 50 MHz system clock
    The faithful RTL closes timing far above its 25 MHz target (an Fmax
    sweep on this branch showed the clk25 domain holds to ~70 MHz, ceiling
    ~75, datapath ~12.8 ns once the router is pushed). Raise the Nexys 4
    system clock to 50 MHz and retune the three clock-coupled constants so
    the design still boots:
    - MMCM CLKOUT0_DIVIDE_F 26 -> 13 (clk25 net now carries 50 MHz; the
    clk25/bufg_25 names are kept so the .xdc selectors and soc_board's
    `clock` port don't ripple). 65 MHz pixel domain untouched.
    - PSRAM phases 2 -> 4 cycles: held at 80 ns wall-clock (4 x 20 ns), so
    every memory / video-DMA timing is byte-identical to the 25 MHz b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
2026-06-30 Phase-9 scratch: add core microbench (baseline cycles/op for MUL/DIV)
    The DSP-multiplier experiment is a throughput change, so it needs a
    measured baseline. test/bench_core.ml drives the real core white-box
    (poke IR + operands, run to retirement) and counts cycles per op,
    isolating the multiplier's contribution.
    Baseline (iterative 33-cycle units): ADD 2 cycles; MUL/MUL'/DIV 34
    cycles (32 stall + 2 issue/commit overhead). A pipelined DSP mult
    cutting the stall to K=2 would be ~4 cycles/MUL (~8.5x per-op); the
    real program speedup is Amdahl-bounded by MUL/DIV frequency (the next
    step: profile the boot). Re-run `dune build @bench` after a multiplier
    change and the stall column is the A/B.
    Co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
2026-06-30 Phase-9 scratch: add boot MUL/DIV profiler (Amdahl context)
    test/profile_boot.ml steps the oracle reset→OS and decodes each
    executed instruction to count dynamic MUL/MUL'/DIV, splitting the ROM
    bootloader from the running OS. Validates against the boot checkpoint
    (handoff detected at instr 403030).
    Finding: booting to a drawn desktop runs ~3122 MUL/DIV (2038 signed
    MUL, 0 unsigned MUL', 1084 DIV) — 0.10% of instructions, a ~3.3%
    Amdahl ceiling on compute (and less end-to-end, since real boot is
    SD-I/O-bound). The idle desktop adds almost none. So the boot/desktop
    workload is NOT multiply-bound: even an ideal 1-cycle mult buys ~3%.
    The DSP win would only show in a multiply-heavy compute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
2026-06-30 Phase-9 scratch: move benches into test/bench/
    Relocate bench_core.ml and profile_boot.ml (and their @bench /
    @profile_boot aliases) into a dedicated test/bench/ with its own dune.
    Pure refactor — no behavioural change.
2026-06-30 Phase-9 scratch: add Multiplier.create_opt (combinational DSP multiply)
    The faithful create stays the proven default; create_opt is a drop-in
    that expresses the 32×32→64 multiply as one signed 33×33 *+, which
    Vivado lowers onto the board's idle DSP48 slices. Combinational, so it
    retires in one cycle (stall tied low) instead of create's 33.
    It reproduces Multiplier.v's §8 sign handling exactly (y always signed,
    x signed iff u), so it is bit-identical to create — the whole
    structural shift-add collapses to operand-prep + one *+. Verified by a
    co-located differential qcheck (create_opt ≡ create, 20000 random
    cases, half with y[31]=1 exercising the unsigned-MUL' H quirk), which
    rides c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
2026-06-30 Phase-9 scratch: bench A/B — iterative vs DSP multiplier in the core
    Extend bench_core to build both cores in one binary and compare: the
    default (iterative Multiplier.create) and the DSP one, swapped in
    through the existing create_with_units seam ({ Units.default with
    multiplier = create_opt }) — no core surgery.
    Result: MUL 34 → 2 cycles (17x per-op; the combinational mult retires
    the cycle it issues), DIV unchanged (still iterative). Integrated
    correctness line confirms R1 matches the proven core bit-for-bit. The
    2-cycle figure is the sim result; whether it survives 50 MHz timing is
    the synth step (a combinational 32x32 in the writeback path may need a
    pipeline stage).
    Co-Authored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
2026-06-30 feat(phase-9): DSP multiplier on the board via ?fast_mul seam
    Thread ?fast_mul through Risc5_core.create -> Soc_board.create ->
    emit_board_verilog (and sim Soc.create for symmetry). When set, the core's
    iterative 33-cycle Multiplier is swapped for the combinational DSP-backed
    Multiplier.create_opt through the existing Units seam -- proven bit-identical
    to the faithful unit by the differential qcheck (which rides create's Phase-8
    formal proof). Default false everywhere: the sim/lockstep/formal stack and the
    faithful port stay byte-identical; only the board netlist opts in.
    Validated: synth infers 4 DSP48E1, 50 MHz closes (WNS +1.521 ns, MUL now the
    critical path); boot checkpoint + visual go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
2026-07-01 feat(phase-9): 60 MHz board build -- pipelined DSP muls + UART baud scaling
    Push the board system clock 50 -> 60 MHz. Three cohesive pieces:
    - Pipelined DSP multipliers. Multiplier.create_opt_pipelined and
    Fp_multiplier.create_opt_pipelined add ?stages pipeline registers on the
    DSP product; Vivado retimes them into the DSP48 MREG/PREG so the multiply
    leaves the critical path. Selected via Risc5_core.create ?mul_stages
    (0 = combinational create_opt, the 50 MHz build; N>0 = N-stage pipelined,
    an N-cycle multiply through the core's existing stall protocol). Each proven
    bit-identical to its faithful unit by a co-located differential qcheck, so it
    rides the Phase-8 proof transitive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
    [nexys4_top.v]
2026-07-01 test(phase-9): lockstep the pipelined-DSP core (fast_mul mul_stages:2)
    Re-run the register-op single-instruction lockstep on a core with the 2-cycle
    pipelined DSP multipliers swapped in (Risc5_core.create ~fast_mul:true
    ~mul_stages:2). MUL (op 10) and FML (op 14) hit the swapped units; the rest ride
    the unchanged glue.
    The units' z + stall are already proven bit-identical to the faithful multipliers
    by the co-located differential qcheck, which drives them from a testbench that
    *mimics* the core's run/stall/operand-hold protocol. This closes the remaining
    sliver: it exercises the units under the *real* core's driving over fuzzed
    operands (broader than a boot stream), verifying the novel 2-cy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
2026-07-01 bench(phase-9): end-to-end gain measurement + bench README
    Add bench_boot (@bench_boot): boot the PSRAM board SoC to the OS handoff and count
    total cycles -- the whole-machine view the memoryless bench_core and the oracle-level
    profile_boot can't see. It measures the DSP-mul A/B at the board's read_cycles=5 and
    sweeps read_cycles 2->5 to isolate PSRAM wait denominator-free (no CPI: the SoC
    re-polls the slow SPI far more than the oracle, so the oracle's instr count is the
    wrong denominator).
    Findings, composing the three gauges:
    - DSP mul is 34->2 cycles/op (17x), but MUL is 0.1% of instructions (profile_boot)
    -> 3.3% Amdahl ceiling -> +0.00% end-to-end on boot. Big local win, ~nil aggrega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
2026-07-01 docs(phase-9): mark compute arc done, add benchmark verdict + Phase 10 (cache)
    Update AGENT.md §5. Phase-9 status -> done (compute arc): the 60 MHz build note
    (pipelined DSP muls, UART baud scaling, pipelined-core lockstep) and the end-to-end
    benchmark verdict -- MUL is 17x/op but 0.1% density, so +0.00% end-to-end; ~24% of
    boot cycles are PSRAM wait (understated for the running OS); the 1.2x clock is the
    broad win. Add a Phase 10 (potential) section scoping a cache -- the memory-bound
    direction the bench points to: I-cache first, then wider/burst PSRAM, with the
    cache-coherence caveat.
2026-07-01 feat(board): Phase-10a — direct-mapped write-through I-cache (Icache)
    Cut PSRAM fetch latency with a cache in front of Cellram — the Phase-9 verdict
    (memory-bound, not compute-bound) acted on.
    Design (boards/nexys-4/icache.ml, board layer — the core stays byte-identical,
    its Phase-8 proof untouched):
    - Async-read distributed RAM (multiport_memory, the register-file idiom) gives a
    0-stall combinational hit: soc_board drops mem_pend to Cellram, whose
    ce = ~mem_pend | ... rises the same cycle, and the word is muxed from the
    cache. No new pipe stage, no core change.
    - Write-through + snoop-invalidate = transparent coherence (Oberon has no flush
    op; the real machine has no cache):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
2026-07-01 refactor: self-contained ROM (Risc5.Rom), relocate board emit + tests
    Housekeeping after Phase-10a; behavior-preserving (same desktop hash).
    1. The design owns its boot ROM. lib/rom.ml (Risc5.Rom) is the 512-word boot
    image, so the published risc5 library is self-contained rather than borrowing
    it from the software oracle. Made it primary: emit + every hardware ~contents
    load Risc5.Rom; the oracle keeps its own Oracle.Boot_rom, and a guard test
    (test/test_rom.ml) pins the two equal so they can never boot different images.
    profile_boot stays oracle-side (it reads ROM words to profile the emulator's
    boot). rom.ml is generated from the oracle's exact words, not hand-typed.
    2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
2026-07-01 refactor(test): fold bench_boot onto the shared board_tb harness
    bench_boot carried its own copy of the Soc_board + Cellram_model wiring; move it
    onto test/boards/nexys-4/board_tb (already shared by the board boot checkpoint +
    visual golden). board_tb.create gains ?fast_mul / ?mul_stages for the bench's
    DSP-multiplier sweep (default off, so the two tests are unchanged); ~contents
    drops to the Risc5.Rom default. bench_boot -82 lines; its dune sheds risc5 /
    nexys4_board (now transitive via board_tb) and ppx_hardcaml (no deriving left).
    Behavior-preserving: @bench_boot unchanged — 5.94x same-work speedup, 93.5%
    hit-rate, 26.28 -> 4.42 cyc/instr.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
2026-07-01 docs(board): add boards/nexys-4/README.md
    A local map of the Nexys 4 board layer: the file/module table, how the board SoC
    works (lib/ Soc with memory behind Cellram + the core on a clock-enable), the
    Cellram PSRAM controller (16<->32 width, ce wait-states, video-priority
    arbitration, the on-chip fast path), the Phase-10a Icache (0-stall LUTRAM hit,
    write-through + snoop-invalidate coherence), and the emit -> synth ->
    program/flash build flow. Deep rationale stays in AGENT.md; this is the local
    orientation + build steps — and it makes the AGENT.md §9 reference to this
    README accurate.
2026-07-03 feat(board): Phase-10b — write-update I-cache snoop (+ ?video A/B seam)
    The 10a snoop-invalidate left the running-OS load hit-rate at 58.7% and
    capacity-flat: the miss autopsy (see the companion bench commit) measured
    96.1% of load misses to be the snoop killing its own lines under Oberon's
    store-then-load stack discipline. A word store-hit now rewrites the line
    in place as {valid, tag, wdata} through the same single write port
    (Icache ?write_update, default off = the proven 10a policy; the board
    emit turns it on). Coherence is unchanged: the update rides the same
    write-through transaction that lands the identical word in PSRAM, the
    ce-frozen core cannot read mid-store, and video never rea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
2026-07-03 bench(phase-10b): running-OS stall profile, video A/B, miss autopsy
    Three new gauges in bench_boot (all under @bench_boot), which together
    found and then validated the write-update policy:
    - Stall profile: every system clock bucketed (retire/exec/compute/
    fetchW/loadW/storeW) + a video-contention overlay, segmented per 250k
    instr. At 10a: CPI 2.16, 39.3% frozen on PSRAM (loadW 21.6%, storeW
    16.1%, video overlay 9.0%; 22.7% port occupancy), write-buffer ceiling
    1.19x with >=2.9x bus-free headroom.
    - ?video A/B: profile + same-work lockstep with vidreq gated — the
    framebuffer-in-BRAM counterfactual, measured 1.228x same-work ceiling.
    - Miss autopsy: an OCaml (valid, tag) mirror of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
2026-07-03 docs(phase-10b): write-update landed — §5 entry, board + bench READMEs
    AGENT.md §5: the 10b table row + the Phase-10 section rewritten (10a/10b
    done, 10c deferred with measured ceilings: write buffer 1.19x,
    framebuffer-in-BRAM 1.228x, page-mode fill; dead ends: bigger/split
    caches, write-allocate, more compute). Board README: the write-update
    policy under the Icache section. Bench README: the Phase-10 gauges +
    the two harness lessons (video DMA is live in every board sim under
    Cyclesim one-domain semantics; probe lookups must be loud).
2026-07-03 fix(board): IRQ stretch under ce-freeze, PSRAM I/O timing budget, reset sync
    Review section-2 follow-ups — all board-layer, lib/ and its Phase-8 proofs
    untouched:
    - soc_board: stretch the ms-timer IRQ across frozen (ce=0) cycles. RISC5.v
    latches intPnd every clock even under stallX, but the board's ce-gating
    froze irq1/int_pnd, so a 1-clock limit tick landing in a PSRAM/video wait
    silently vanished (~58% of ticks under a load loop). The held request
    reduces to irq = limit exactly whenever ce=1 (lib Soc semantics unchanged)
    and is inert to Oberon (never runs STI). Co-located test pins 40/40
    delivery; teeth-checked at 17/40 with the stretch disconnected.
    - nexys4.xdc: constrain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
    [nexys4.xdc, nexys4_top.v]
2026-07-03 chore(review): convention + test-hygiene nits (review section 4)
    Eight small fixes from the repo review; no behavior change anywhere —
    the two netlist-touching refactors are re-proven by @formal:
    - risc5_core/rs232r: bind the mixed &:/|: groupings by name (ld_or_st,
    frame_done) — the one spot where left-assoc parses right but reads wrong
    under Verilog/C intuition, plus its sibling. Clarifying parens don't
    survive dune fmt (stripped as redundant); a let-binding is the enforceable
    form. frame_done also dedups an expression rs232r built three times.
    - cellram: waveform expect test re-frozen at wave_width:4 (the §6 floor) /
    display_width:150 — the old block truncated 32-bit hex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
2026-07-03 docs: fix doc-vs-code drift across the tree (review section 3)
    Comment/doc-only sweep — no netlist or behavior change anywhere:
    - UART: emit_board_verilog + rs232r/rs232t docs now state the truth — the
    board deliberately passes 521/521 (both fsel settings ~115200; reads are
    wire-limited, oat runs 115200; no 19200 mode is wired). The previously
    documented 3125/521 split was never shipped.
    - SPI: the board override is 8 (clk/256 = 234 kHz at 60 MHz), not the
    50 MHz-era 7 (clk/128); test title/comments re-framed accordingly.
    - FP unit .mlis: operand 2 is C0 (the raw register read — the FP units are
    register-register, never the q-muxed immediate); the C1 claim was a
    copy-paste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
    [core.cpp, nexys4.xdc, nexys4_top.v]
2026-07-03 refactor(test): move bench_boot into the board-test mirror (namespacing)
    test/bench/ had grown a board coupling: bench_boot depends on board_tb
    (test/boards/nexys-4), drives Soc_board's full knob surface, probes board
    signal names, and its subject IS the board memory system — while its two
    siblings are target-independent (bench_core = lib units, profile_boot =
    oracle). A board-specific artifact living outside the test/boards/<target>/
    mirror broke the namespacing, and every new board knob rippled through a
    cross-namespace chain (soc_board -> board_tb -> test/bench).
    Move bench_boot.ml to test/boards/nexys-4/ next to the board_tb harness it
    uses and the board tests it complements. test/ben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
2026-07-03 refactor: role-based module names — the library reads as the machine
    Rename modules for their role in the machine rather than 1:1 after the
    Verilog sources ("the Verilog is the spec" binds behavior and register
    names — never file names; each .ml header keeps naming the RTL file it
    ports). New AGENT.md §9 bullet records the principle and its exceptions.
    lib/ (the machine's anatomy):
    - risc5_core -> cpu (Risc5.Cpu; header still says "port of RISC5.v")
    - sram -> ram (the ram/rom pairing; Hardcaml.Ram shadows the
    bare sibling name after open Hardcaml, so its
    one consumer — lib/soc.ml — binds it before t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
2026-07-03 bench(phase-10): stall profile + video ceiling measure the shipped policy
    The running-OS stall profile and the framebuffer-in-BRAM gating ceiling
    still ran the 10a snoop-invalidate policy after 10b landed, so the
    profile kept reporting a loadW bucket (21.6%) that write-update had
    already eliminated. Thread ?write_update through stall_profile and run
    both profiles + the ?video ceiling lockstep on the shipped config.
    The corrected 10b baseline: CPI 1.75, 25.0% of clocks frozen — storeW
    22.1% (88% of frozen), read-wait 3.0%, video contention 5.0% on 22.8%
    port occupancy; write-buffer ceiling 1.28x at 2.6x bus-free headroom.
    The framebuffer-in-BRAM same-work ceiling re-measures at 1.180x (the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
2026-07-03 feat(phase-10c): framebuffer BRAM shadow — video DMA off the PSRAM port
    The corrected baseline put the video bus tax at a 1.180x same-work
    ceiling: the PSRAM port serves video 22.8% of all clocks and the CPU
    freezes behind it 5.0%. Remove the traffic at the source — the cache's
    coherence trick applied to the framebuffer window:
    - Framebuf (board layer): four byte-lane 32768x8 sync-read BRAMs (the
    lib/ram.ml byte-enable idiom; sync read = block-RAM inference)
    covering the full DMA-addressable span [Vid.org, Vid.org+0x8000) —
    no blanking-time assumptions; Vid.org newly exported so there is one
    constant. Every PSRAM-bound store in the window (exactly the store
    the cache snoops)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
2026-07-03 build(phase-10c): enable fb_bram on the board; document the phase
    emit_verilog flips ~fb_bram:true. Synth: the four fb* arrays infer as
    block RAM — 32 RAMB36E1, the design's first BRAM use (23.7% of 135) —
    720 LUTRAM unchanged, and 60 MHz closes at WNS +0.213 ns with the
    critical path still the cache write (the shadow write port is an
    18-bit window compare into a registered BRAM port, off the hot path).
    Boots clean on real hardware; desktop smooth.
    Docs: AGENT.md gets the 10c table row + narrative (and the deferred
    list becomes 10d with post-10c ceilings: write buffer 1.22x at 4.4x
    bus-free headroom as the next lever, page-mode largely subsumed);
    the board README gets the Framebuf secti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
2026-07-03 feat(phase-10d): 1-entry write buffer in Cellram — stores retire in one ce cycle
    Post-10c the residual frozen cycles were 92% store-wait (18.3% of
    clocks): every write-through store froze the core ~11 cycles while the
    two-phase PSRAM transaction ran. Add ?write_buffer (default off): a
    PSRAM-bound store retires the cycle the 1-entry slot captures it
    ({adr, ben, wdata}; wb_accept joins the ce equation, and capture needs
    no port, so it works even mid-video-op), and the write drains in the
    background riding the machinery the controller already had — an
    op_wb-tagged write op, excluded from the CPU's ce exactly as video ops
    are, and exempt from video preemption because it is a write.
    Hazards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
2026-07-03 bench(phase-10d): thread ?write_buffer; measure the win and the residual
    Soc/Board_tb gain the ?write_buffer seam (default off — the proven
    synchronous write path); the golden gains WBUF=1 so the coherence proof
    runs the full stack (byte-identical desktop + all 32768 shadow words =
    the PSRAM window, with cache + write-update + fb_bram + wbuf all on).
    Two new gauges in bench_boot, measured against the 10c config:
    - same-work lockstep, sync stores vs the buffer: 1.237x (CPI
    1.90 -> 1.53 over a 126.8K-instr aligned prefix) — above the 1.22x
    ceiling estimate, which priced misses off a different stream;
    - wbuf-ON stall profile: long-window CPI 1.64 -> 1.45, frozen
    19.9% -> 9.5%. The re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
2026-07-03 build(phase-10d): enable write_buffer on the board; document the phase
    emit_verilog flips ~write_buffer:true (paired with fb_bram, as the
    ordering argument requires). The stock implementation flow then FAILED
    timing: RamUBn missed the 6.7 ns PSRAM I/O output budget by 0.163 ns —
    pure placement (3.3 ns of route to the pad; the byte-enable cone is
    untouched by the buffer), so build.tcl now runs Explore-class
    directives (place/phys_opt/route), which close it at WNS +0.130 ns and
    write the bitstream; the structural fallback if the margin ever flakes
    again (register the byte-enable pins) is documented in the script.
    Boots clean on real hardware; a compile runs fine.
    Docs: AGENT.md gets the 10d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
2026-07-03 feat(phase-10d): generalise the write-buffer slot to a ?wbuf_depth FIFO
    The depth-1 residual storeW (7.5% of clocks) is slot-full waits, and
    its shape is known: Oberon procedure prologues store in pairs. Turn
    the single slot into a 1..4-entry FIFO — slot 0 (the oldest) is the
    drain source, a completing drain shifts the queue down one, and an
    accepted store lands at the tail (position wb_cnt, or wb_cnt-1 when a
    drain completes the same cycle: all right-hand sides read pre-edge
    values, so the shift copies the old tail even as the new store
    overwrites it). wb_cnt counts occupied slots including the one
    mid-drain, so drain-before-read (wait for wb_cnt = 0) and the whole
    coherence argument are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
2026-07-03 bench(phase-10d): measure the depth-2 FIFO and price the rc=6 trade
    Thread ?wbuf_depth through Soc/Board_tb; the golden's WBUF env now
    carries the depth (WBUF=2), and its boot runs the board's read timing
    (read_cycles 6 / write_cycles 5). make_os/stall_profile gain
    ?read_cycles so latency trades can be measured, not estimated.
    Three new gauges:
    - depth-1 vs depth-2 same-work lockstep: 1.066x — near the 1.08x
    all-depths ceiling, confirming the burst hypothesis (2-store
    procedure prologues dominated the slot-full waits);
    - depth-2 profile: CPI 1.45 -> 1.36, storeW 7.5 -> 1.7%; the ceiling
    from there is 1.02x, so depth 3+ is measured dead;
    - rc5 vs rc6 same-work lockstep + rc6 profile: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
2026-07-03 build(phase-10d): ship wbuf depth-2 + the rc=6 I/O margin trade; docs
    emit_verilog flips ~wbuf_depth:2 and ~read_cycles:6 (write phase stays
    5). The rc=5 PSRAM I/O budget — 13.3 ns split 6.7/6.6 across the
    address-out and MemDB-in groups — had become a standing knife-edge as
    the design grew (RamUBn failed by 0.163 ns at 10c+wbuf, then two
    builds grazed at +0.130 and +0.009): the 100 ns read phase re-derives
    it to 30 ns, split 12/12 in nexys4.xdc with the derivation note
    updated (the .xdc had pre-planned exactly this escape hatch). Measured
    cost 0.86% same-work against ~5 ns of standing margin per I/O group;
    post-route WNS +0.169 ns with the worst path back on the internal
    cache-write pat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
    [nexys4.xdc]
2026-07-03 refactor: vid.ml -> video.ml — role-based module naming (§9)
    Vid was the one module still named after its RTL source (VID60.v's
    module is literally VID) rather than its role; the library anatomy now
    reads cpu / ram / rom / alu / video. Module + file rename only:
    - signal names stay (vidadr, vidreq, cr_op_vid, ... read fine as
    short-for-video, and §2 binds register names, never file names);
    - the formal/cosim artifact names stay (vid.ys.template,
    vid_invariant.*, vid.cpp, vid_dump.ml) — they label checks against
    the Verilog unit, where the RTL-derived name is the right one;
    - doc references to the module/file updated in place (AGENT.md, the
    READMEs, nexys4.xdc comments, odoc {!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
    [nexys4.xdc, vid.cpp, vid_invariant.v, vid_stubs.v]
2026-07-05 test(soc): guard SoC-glue reset fidelity + document the EO reset finding
    Live hardware debugging of "Extended Oberon behaves differently after the
    reset button" traced the fault to the Nexys-4 USB-HID mouse bridge mishandling
    a spec-faithful mid-stream PS/2 re-init (phantom right-button bits), NOT to any
    RTL drift: the SoC reset fanout and the free-running ms timer both match
    RISC5Top.OStation.v on inspection. These tests lock that fidelity in as a
    regression gate for the drift-class, and RESET-FINDINGS.md records the full
    investigation for the fix phase.
    lib/soc.ml:
    - ms timer free-runs across a mid-run reset (expect): cnt1 keeps climbing
    through an asserted reset spanning several ticks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
2026-07-05 docs(nexys-4): remove RESET-FINDINGS.md; keep the reset-fidelity guards
    The doc's root-cause theory (phantom HID-bridge mouse bits vetoing commands +
    starving the serial poll) was disproven by later testing: the same failure —
    after a reset, EO doesn't launch Hilbert.Draw etc. — reproduces in the
    reference emulator (clean reset, lossless wire), so it is EO software behaviour,
    not a board/gateware fault. Removing the doc rather than shipping a wrong
    narrative; the correct write-up waits until the EO-side cause is pinned.
    Kept: the three SoC-glue reset-fidelity guards from 9c137f6 (they stand on their
    own — free-running ms timer survives a mid-run reset, only the faithful register
    set c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
2026-07-05 feat(board): widen memory decode to 24-bit (16 MiB himem) — DOOM.md 2a
    Widen Cellram/Cache/Framebuf word address 18->22 bits so the full 16 MiB
    PSRAM chip is addressable, exposing [1 MB, 16 MB) himem for the DOOM
    blob/zone/WAD (DOOM.md §3). The core (lib/) and Oberon are untouched —
    still a 1 MB machine; only a high adr reaches himem.
    - Cellram: req_word + write-buffer FIFO 18->22b; video path zero-extended;
    mem_adr now the exact 23-bit halfword address.
    - Cache: tag 18->22b word address (tag_w 8->12 @ 1024 lines); guard 1..21.
    - Framebuf: window compare widened — fixes a himem-store aliasing bug that
    would corrupt the video shadow / break shadow == PSRAM.
    - Cellram_model: ?addr_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
2026-07-05 chore(vendor): bump emulator to risc5_isa decode (develop @ e36fcf0)
    Move the oberon-risc-emu-ocaml submodule pin 293064a -> e36fcf0:
    - Add generated opam file to automate dependency install
    - Decode single_step through a shared risc5_isa instruction module
    The emulator's public risc.mli is unchanged, so the oracle (copy_files
    glob) absorbs risc5_isa.ml/.mli with no source or dune changes here.
    Full gate suite green on the new pin: fast runtest (250k+ single-instr
    lockstep cases), @boot_checkpoint, @visual_golden (hash 0xb9bdbf56ba51298d),
    @cosim 10/10, @formal 17/17.
2026-07-05 refactor: rename `oracle` library/`Oracle.*` to `emu`/`Emu.*`; disambiguate "oracle" in AGENT.md
    The vendored OCaml emulator wrapper was aliased `oracle` (library) / `Oracle.*`
    (modules). "Oracle" is a role, not an identity — and `RISC5.v` (run through
    Verilator) is also an oracle, the wire-state/fidelity one. Rename the identifier
    to `emu` so "oracle" is free to name the role both artifacts play.
    Mechanical rename:
    - vendor/oracle/ -> vendor/emu/; library `oracle` -> `emu`
    - Oracle.* -> Emu.* across lib/ + test/ (83 refs); (libraries oracle) -> emu
    - identifier/path refs in AGENT.md + test/cosim/README.md
    Prose pass (AGENT.md only):
    - bare "the oracle" meaning the OCaml model -> "the em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
2026-07-06 chore(vendor): bump emulator to 6a2ad32 (risc5_isa fmt-only)
    Pure ocamlformat reflow of risc5_isa (janestreet profile; upstream
    dropped the .ocamlformat version pin). Behavior-neutral — parent build
    is clean and the CPU<->emu lockstep + FP/ROM guards all pass against the
    new commit.
2026-07-07 feat(board): PS/2 keyboard on a Pmod PS/2 in JA — on-hardware bring-up
    The Phase-7 pending item closed. The Digilent Pmod PS/2 in JA's top row
    carries the keyboard; the onboard PS/2 port (USB-HID PIC) stays with the
    mouse.
    - nexys4.xdc: kbdClk = D17 (JA3), kbdDat = B13 (JA1), LVCMOS33 + PULLUP
    (Pmod PS/2 ref-manual pinout: pin 1 = DATA, pin 3 = CLOCK; JA pins per
    the Digilent master XDC). Receive-only, so plain inputs — no IOBUF.
    - nexys4_top.v: kbd pads wired straight into soc_board's ps2c/ps2d,
    replacing the 1'b1 tie-offs (PS2.v's own Q0/Q1 chain synchronises the
    clock; ps2d is sampled well inside the >=5 us hold window). LD12
    repurposed from the retired mouse btns_ever diag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
2026-07-09 feat(board): 16 KiB icache — DOOM's capacity lever (+39% fps on hardware)
    Bump the board icache from the 4 KiB / 1024-line default to 16 KiB
    (lines_log2:12 — 4096-line async-read LUTRAM, 2822 LUTs, 0 extra BRAM).
    Phase 10's "capacity-flat" hit-rate was an Oberon-OS fact (its hot loops
    fit a few KB). The DOOM workload (sibling DOOM-on-Oberon) is the opposite:
    a throwaway access-stream replay of the DOOM blob (the emulator's exact
    fetch+load stream through a cache mirror, bit-identical to the board per
    the desync oracle) put read-miss stall at 51% of the frame, and it is a
    *capacity* problem — 55% of misses are instruction fetch (the renderer
    code footprint), 28% loads into the 30.7 KB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
2026-07-09 feat(board): swap PS/2 ports — 3-button mouse on Pmod PS/2, USB keyboard onboard
    The port assignment inverts now that a genuine 3-button PS/2 mouse is in
    hand: the mouse moves to the Digilent Pmod PS/2 in JA (msClk=D17/JA3,
    msDat=B13/JA1) and a USB keyboard takes the onboard USB-HID port
    (PS2Clk=F4/PS2Data=B2, the PIC24 bridging it to PS/2). The direction
    machinery follows the device ROLE, not the connector: the open-drain
    IOBUFs + msclk_oe/msdat_oe migrate to the Pmod pins (the Mouse module
    transmits its init), and the onboard pins become two plain inputs
    (PS2.v's keyboard side is receive-only — the ref manual explicitly
    blesses input-only hosts). LD12's keyboard one-shot follows to F4;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
    [nexys4.xdc, nexys4_top.v]
2026-07-09 docs: add MIT LICENSE + a minimal README
    A placeholder front page for the now-public main: what the project is,
    the hardware status, the two-oracle verification story, and pointers to
    AGENT.md / the board README. Proper write-up to follow.
2026-07-10 feat(board): Indexbuf — the indexed-colour display mode; DOOM's dither moves into scanout
    The machine's second display mode (its first had no mode register at all): a
    320x200 chunky-8bpp framebuffer scanned out to the 1024x768 mono panel
    through a CPU-programmed luminance LUT and a CPU-UPLOADED ordered-dither
    threshold map. Born as the DOOM arc's fps lever #3 — the software dither was
    57% of the tick, instruction-bound at its legibility floor — and generalized
    CONTENT-FREE in review: the hardware bakes only geometry (the mode-13h fit
    this panel forces); every client uploads its rendition before mode-on. DOOM
    brings its blue noise, Mandel.Mod (DOOM repo) a computed Bayer — the design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
2026-07-14 feat(board): Indexbuf v2 — the generality rework; geometry joins the uploaded policy
    The v1 experiment baked 320x200 -> fullscreen into ROMs; v2 keeps only
    mechanism in hardware. Vertical geometry = a CPU-written row map
    ({thr_row, row_base} per rect-relative output line — no vertical DDA, no
    multiplier); horizontal = the XNUM/XDEN/XOFF output-pixel DDA (16/5
    reproduces the v1 slot tables exactly); the threshold map uploads VERBATIM
    (the slot-quad packing dies); the whole-screen mode mux becomes a
    per-request overlay-rect CLAIM against Framebuf (word-aligned in x);
    geometry registers are shadowed and latch at vblank entry — detected as a
    REQUEST GAP (Video gates req0 with ~vblank, so b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
2026-07-14 refactor(board): Indexbuf -> Halftone — the merge-round rename
    The v1 name described the storage format; v2's identity is the transform —
    threshold-map screening of a tone-mapped window at scanout, i.e. halftoning
    — and the Oberon face (the DOOM repo's stub/Halftone.Mod) had already named
    itself. Scheme: module Indexbuf -> Halftone, ?indexbuf -> ?halftone, RTL
    names ixb_* -> ht_* (doom_sim's string-matched probes rename in lockstep),
    golden env var INDEXBUF=1 -> HALFTONE=1. Name-only: runtest green, fmt
    clean, and the DOOM blob rebuilt byte-identical across the rename.
2026-07-14 docs: record the Halftone display mode — AGENT.md §5 row 11 (display arc)
2026-07-14 chore(vendor): bump emulator to b92abdc (host-tools: 16 MiB RAM + risc_core rework)
    Bumps the risc_core oracle submodule 6a2ad32 -> b92abdc (feat/host-tools,
    now merged to the emulator's main/develop). For the emu wrapper (which
    copy_files-compiles the submodule's lib/), this brings the widened 16 MiB
    RAM + decoupled framebuffer window (f52d904), the reworked risc.ml/risc.mli
    plus disk/io/fp, the new lib modules (shim, oberon_name, ...), and the
    core/frontend simplification; the host tools themselves live outside lib/.
    Full parent gate green against the new HEAD:
    - build clean; dune test (CPU<->emu lockstep, FP-vector + fuzz vs Emu.Fp,
    boot-ROM guard)
    - @boot_checkpoint + @boot_chec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
2026-07-14 refactor(board): rename boards/ -> board/ for naming consistency
    Make the board layer dir singular, matching the other top-level dirs (lib,
    test, vendor). Renames the dir and its test mirror:
    boards/ -> board/
    test/boards/ -> test/board/
    Functional path updates: root dune (dirs stanza), .gitignore (the two
    _generated/_build ignore entries), and gen_verilog.sh (the gen= var + the
    board/nexys-4/emit_verilog.exe dune targets). All other occurrences are
    doc/comment path references. Unchanged: the .tcl scripts' relative-path
    logic, library names (nexys4_board, board_tb), and the emitted soc_board
    module. Remaining bare 'boards' tokens are prose (keyboards, gaming boards,
    all-boards),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
2026-07-14 feat(board): Mod/ — the Halftone driver + demo ship with the hardware they drive
    board/nexys-4/Mod/Halftone.Mod: the display mode's Oberon-07 driver — the thin
    single-owner system service (Open + LinearRows + a threshold upload + On) any
    Oberon program uses to put grayscale pixels on the 1-bit panel; its register
    constants mirror halftone.mli. Mod/Mandel.Mod: the demo client — a cooperative
    Mandelbrot infinite-zoom viewer citizen, zero DOOM code or content, the
    display mode's generality witness. Both hoisted from the sibling
    DOOM-on-Oberon so ONE commit (and one submodule pin downstream) captures
    design + emulator + driver + demo. Not dune material: the sibling's
    script/mkdisk.sh compi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
2026-07-14 docs: follow the sibling's tool renames — run_sim / run_dsk / run_blob, script/mkdsk.sh
2026-07-14 docs: the Halftone seam spec lives in the sibling's ABI §11 — pointers follow
    The draft seam doc (DOOM repo halftone-seam.md) is promoted into ABI.md §11
    over there, per its own promotion condition — the mode shipped. halftone.mli,
    Mod/Halftone.Mod and the §5 row 11 design-record note now point at ABI §11.
2026-07-14 feat(board): Halftone claims the rect — single-owner enforced, and Mandel goes Stars-patterned
    Two live viewer clients (Mandel zooming + the sibling's DOOM.Run -win) used
    to fight over the one rect in hardware: each re-claimed whenever its own
    modeOn was false, each re-uploaded ITS tables, and the loser's suspend/close
    path called Off — killing the winner's mode. The old contract ("the doc is
    the arbiter") was social; now Halftone.Mod enforces it, hardware untouched:
    - Open CLAIMS the rect — while a claim is live, every further Open (any
    caller's, including the owner's) returns FALSE and writes nothing;
    - Off RELEASES it — every client already brackets hardware use in
    successful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
2026-07-14 feat(board): the claim moves to consumer lifetime — Claim/Release bracket the viewer's life
    Same-day redesign of b8a0238's arbitration, on zxy's rule: "exit the current
    consumer first, then open the next." The claim now spans the CONSUMER's
    lifetime — a viewer from open to close, or one command — not the display
    mode's:
    - Claim takes the rect (FALSE = another consumer lives: report, and the user
    closes it first); Release frees it — parameterless, so Halftone.Release is
    the middle-clickable recovery command;
    - Open reverts to (re)shape-only and Off to blank-only, both legal INSIDE
    your claim, through suspend and resize alike. Open still refuses when no
    claim is live (a forgot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
2026-07-20 chore(vendor): bump emulator to 88f5fe8 (screenshots + oat absorbed)
    Upstream develop adds framebuffer screenshots (--shot-frames headless,
    F10 windowed) and absorbs the oberon-agent serial client as oat/. The
    lib/ delta our emu wrapper compiles is additive/behavior-identical
    (U32 LE32 codec helpers, ?on_frame observer on Headless.run_frames).
    Verified: @check, dune runtest, @boot_checkpoint, @visual_golden, and
    @visual_golden_board at the shipped config (ICACHE=1 WRITE_UPDATE=1
    FB_BRAM=1 WBUF=2 HALFTONE=1) all green.
2026-07-22 docs: AGENT.md becomes the working manual — the build history moves to build-log.md
    The phase log (0-11) and the three arc narratives move to build-log.md,
    restructured per-phase (Landed / Design / Results / Proven by / Lessons)
    instead of the monster table rows. AGENT.md keeps the mechanical parts —
    locked rules, verification machinery, ISA + divergence reference, toolchain —
    at 484 lines from 831. Along the way: stale facts fixed (PDF locations,
    prom.mem/.ucf, the 24-bit himem decode), sibling repos now GitHub URLs (the
    pdewacht C reference dropped from the list), §1-§9 numbering preserved for
    the code citations, and the §0 learning framing retired — its still-live
    principles (v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
2026-07-22 refactor(lib): the MMIO layer says it once — io_reg/word-map collapse the SoC boilerplate
    A /simplify sweep of lib/ (4 review lenses: reuse, simplification, efficiency,
    altitude). No behavior change anywhere — every touched unit stays green under
    @formal (17/17), and the sim SoC re-passes @boot_checkpoint + @visual_golden
    (hash 0xb9bdbf56ba51298d); the rebuilt bitstream closes timing (WNS +0.017)
    and boots on the board.
    - soc.ml: io_wr/io_rd strobes + an io_reg combinator replace the five
    copy-pasted writable-register blocks (gpout's faithful no-reset becomes an
    explicit ~rst:false); named MMIO word constants + a structural read map tie
    each word's decode site to its read slot; lo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
2026-07-22 refactor(lib): the peripheral cluster becomes a module — Peripherals owns the MMIO map
    The RISC5Top peripheral/MMIO block (timer, SPI + spiCtrl, UART + bitrate, PS/2
    kbd + mouse, switches/LEDs, GPIO, the read mux) moves out of the sim SoC into
    lib/peripherals: one faithful block, with the board's departures as explicit
    seams — ?slow_div_log2 / ?baud_* retunes, ?extra_read_slots for SoC-specific
    read words (collision / range / width fail at elaboration), and exports for
    board-side derivations (spi_ctrl → sd_cs, ms_tick → the ce-domain IRQ stretch).
    The named word map is exported; register names (cnt1, spi_ctrl, limit) stay
    inside and flat, so every by-name lookup in the harnesses is u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
2026-07-22 refactor(board): the hand-copy dies — the board SoC adopts the shared Peripherals
    board/nexys-4/soc.ml deletes its copied peripheral/MMIO block (the header used
    to say "a faithful copy of soc.ml … can drift from it" — it had) and
    instantiates the shared cluster. Every board delta is now visible at the call
    site instead of buried in copied text: the slow_div_log2 / baud retunes
    (emit_verilog.ml knobs), ht_status at read slot 10 via ?extra_read_slots,
    sd_cs derived from the exported spi_ctrl, and the ce-domain IRQ stretch
    wrapping ms_tick. rom_region now derives from Cpu.start_adr like the lib SoC.
    Timing-transparent, proven: @boot_checkpoint_board and @visual_golden_board
    (FB_BRAM=1 WR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
2026-07-22 docs(board): the test comments stop describing the dead hand-copy
    Two comments still claimed the peripheral block was a copy that could drift;
    it is the shared Peripherals cluster now, and the drift-guard tests' remaining
    purpose is the ce interplay only the board composition exercises.
2026-07-22 refactor(board): the /simplify pass — loud guards, one-source spans, deduped scaffolding
    Four-lens cleanup of board/nexys-4 (reuse / simplification / efficiency /
    altitude), all behavior-preserving — the board checkpoint and the all-knobs
    visual golden re-pass byte-identical (0xb9bdbf56ba51298d), every frozen
    [%expect] verified unchanged.
    Guards (silent failure -> elaboration error): halftone without fb_bram used to
    elaborate with no Halftone at all — an A/B run would "measure" a build that
    never instantiated it; Cellram's read/write_cycles outside the 4-bit phase
    counter died as an opaque width error nowhere near the knob. Both fail loudly
    now, like the lib guards.
    One source of tru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
2026-07-22 refactor(test): the board test closure lives once — Soc.For_tests owns Tb + drive_idle
    The /simplify follow-up: the SoC + Cellram_model closure and the idle-level
    driver move into board soc's exported For_tests (the Ps2.For_tests precedent),
    shared by the co-located tests and the test/board harnesses. board_tb becomes a
    thin veneer — it re-exports For_tests.Tb's I/O, keeps only the test-side
    conveniences (the boot-ROM contents default, the full-size 1 MiB model for the
    disk-booting gates, read_word), and forwards the knobs. The five hand-typed
    idle-level blocks across the boot checkpoint, the visual golden and bench_boot
    (x2) are each one Board_tb.drive_idle call: adding a board input is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
2026-07-22 build(toolchain): the jsonaf fork retires — preview rolls to 130.106+341 on plain upstream
    Upstream jsonaf fixed its unsatisfiable `@@ portable` annotations at
    130.100+614, so the zxygentoo/jsonaf fork pin is dropped and the whole
    ox preview stack rolls 130.91+190 -> 130.106+341. Two churn items land
    with it:
    - waveterm capture moved into core Hardcaml: Cyclesim.Waveform.create
    + Hardcaml_waveterm.Waveform.print replace For_cyclesim (19 files,
    mechanical); the two shifter waveform expects reflow because rendered
    signal order now follows interface declaration order.
    - ppx_expect >= 130.100 resolves expect-test sources as
    <source-tree-root>/<basename> while dune passes %{workspace_r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
2026-07-23 refactor(test): simplify slice 1 — shared plumbing (sd_bridge, fork_pool, board_tb)
    board_tb's 13-option forwarding veneer collapses to a partial application
    of Soc.For_tests.Tb.create (contents + addr_bits pinned; new Tb knobs now
    flow through untouched). ?contents leaves the contract (never passed by a
    caller); ?clocks_per_ms joins it (it always forwarded). sd_bridge's nested
    byte/bit unpack loops become one Array.init; the deselected fill unifies
    to 0xFFFF_FFFF. fork_pool drops its nonempty helper for List.is_empty.
    Verified: all 8 gate captures byte-identical to the clean-tree baseline
    (timing-normalized); mutation seed (sd_bridge LSbit-first flip) turns
    @boot_checkpoint red (NO HANDO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
2026-07-23 refactor(test): simplify slice 2 — the lockstep harness dedups its per-shape scaffolding
    test_cpu_lockstep's four decoders built the case record's flag fields
    inline (the bit layout written five times across the file); case_of now
    single-sources it against packed_flags. The oracle poke sequence
    (3x), the (regs, flags, pc, h) readback (2x), and the 16-register +
    flags/pc/h comparison (3x) each collapse into one helper (poke_oracle /
    read_oracle / state_eq). Generators, §8 steering, and the cycle
    protocols are untouched. fp_replay / test_fp_* / test_rom reviewed:
    already factored, no change.
    Verified: dune runtest --force fingerprint identical to baseline
    (order-normalized); mutation seed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
2026-07-23 refactor(test): simplify slice 3 — the four boot gates share their two halves
    boot_checkpoint_common becomes the Hardcaml-free half of all four boot
    gates: make_oracle (frontend wiring, was written 3x), the fb geometry +
    boot_oracle_fb + popcount/render/fb_fnv, the closure-parameterized
    run_to_settle, and golden_report (labels parameterized so each golden's
    historical output lines stay byte-exact). New boot_tb library carries
    the Cyclesim side: loud lookups, flags_word, the Spi attach/tick block
    (was written 4x), and run_to_handoff (the checkpoints' shared
    drive/snapshot body; reset + RAM readback as closures). The gates
    shrink to their SoC-specific residue: 105->57, 101->59, 263->117,
    377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
2026-07-23 refactor(test): simplify slice 4 — the core capture joins the shared boot plumbing
    risc_core_dump drops its private project_root/copy_to_temp/DISK_IMG
    block (the last copy of the triplication) for BCC, and its hand-rolled
    lookups + SPI-step block for Boot_tb — the SPI ctrl decode now exists
    in exactly one place. Its load-bearing split-phase capture loop is
    untouched: Boot_tb.Spi.tick decomposes into set_miso/step so the
    capture calls the halves around its own edge. Boot_tb gains
    lookup_node (node-or-reg, per the §6 gotcha). The repo-root walk moves
    to Fork_pool.cd_to_repo_root (cosim_run adopts; formal_run in slice 5).
    The stimulus dumpers and all C++ (the frozen contract side) are
    revi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
2026-07-23 refactor(test): simplify slice 5 — the formal runner sheds its private plumbing
    formal_run adopts Fork_pool.cd_to_repo_root (the third and last copy of
    the repo-root walk) and gains report_sec — the Formal_equiv/Sec twin of
    the yosys report helper — collapsing run_combinational and
    run_vid_addr's hand-rolled match-and-print. Report strings are
    byte-identical. Reviewed and unchanged: yosys_equiv / formal_equiv
    (version-shim-bearing), core_blackbox (irreducible port/rename
    mapping), every .ys.template and .v spec (the frozen side), and both
    runner mains (their argv/jobs shapes differ for documented reasons).
    Verified: @formal 17/17 fingerprint identical to baseline on the
    refactored run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
2026-07-23 refactor(test): simplify slice 6 — the gauges adopt the shared boot plumbing
    bench_boot's boot_cycles and make_os shed their private some/lookup
    scaffolding and SPI tick blocks for Boot_tb (make_os's step closure is
    now one line); the cache-stat sampling moves after the tick — provably
    equivalent, the bridge step never touches the sim. The loud-lookup
    rationale (the cr_busy register trap) stays. profile_boot's hand-wired
    oracle preamble becomes BCC.make_oracle (the last copy). All
    measurement logic — instruction lockstep, miss autopsy, stall profile,
    sweeps — untouched; bench_core reviewed, unchanged.
    Verified: all three gauge reports (@bench, @profile_boot, @bench_boot)
    byte-identi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
2026-07-23 perf(test): the boot gates shed their SPI wait — SPI_DIV_LOG2 turbo knob + golden early-exit
    The heavyweight gates were never interpreter-bound (Cyclesim holds ~0.24 M
    cyc/s; trace_all free, release profile nil): a per-cycle probe showed 80% of
    boot-to-handoff cycles are slow-mode SPI transfers (11,985 x 512 cyc at
    SPI.v's clk/64 — SD init + the boot ROM's early reads), and the goldens then
    spend ~6.5 M more cycles re-confirming an already-stable framebuffer.
    Two test-side levers, default-off, end states byte-identical:
    - SPI_DIV_LOG2 env knob on all four boot gates, riding the existing
    ?slow_div_log2 seam newly plumbed through lib/Soc.create and the board Tb
    (the shipped board alr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
2026-07-23 docs: record the boot-gate speedup — the SPI_DIV_LOG2 knob in §9, a build-log postscript
    AGENT.md §9 gains the fast-iteration knob (and the @check-does-not-link-exes
    gotcha); build-log.md gains the postscript with the probe findings and the
    measured before/after numbers.
2026-07-23 docs: tighten the §9 fast-mode note — the manual points, the postscript explains
2026-07-23 bench(board): bench_boot honours the boot gates' fast mode
    SPI_DIV_LOG2 forwards to both sim sites (boot_cycles, make_os) and the report
    banners the mode first. Validated against the recorded baselines: the
    lockstep/A-B/autopsy ratios hold (10a 5.92x vs 5.94x, write-update 1.298x vs
    1.305x, fb-BRAM 1.181x vs 1.180x, mirrors 0-mismatch); boot-cycle absolutes
    shift as documented (the knob removes the SPI wait they measure) and stay
    faithful-divider-defined — the README says which is which. ~20-25 min -> ~8.
2026-07-23 feat(board): the clock push — 64 MHz on the post-simplify seed, HW-validated
    The post-simplify +0.174 WNS was placement lottery, not logic reduction:
    pre-dedup / pre-simplify / develop netlists are the same size (Hardcaml
    already shares structurally-equal nodes) and rebuild at +0.000 / +0.001 /
    +0.174 on the same toolchain — and the recovery loop censors (stops at
    WNS >= 0), so recovered builds park at ~+0.00x. The lottery cuts both
    ways, so the clock rides it instead:
    - MMCM VCO 780 -> 1040 (= 64 x 16.25 = 65 x 16): system clock 60 -> 64 MHz
    with the 65 MHz pixel clock still exact (CLKOUT0_F 16.250, CLKOUT1 16).
    - PSRAM I/O groups 12.0 -> 11.7 ns (rc=6 read phase leaves 23.75 ns at 6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
2026-07-24 chore(gitignore): _opam/ -> /_opam — the dir-only pattern misses the switch-link symlink
2026-07-25 docs: slim the manual — §9 drops the layout tree, git-flow in one sentence
    The tree was discoverable or already documented; the four facts that
    weren't fold into §3 (cellram_model, the Vivado flow scripts), the intro
    (the CLAUDE.md symlink), the .mli bullet (the .ml-header convention),
    and a git-ignored-dirs bullet. §7 stays: ~25 code comments cite §8 by
    number and cpu.ml cites the §7 cc table — renumbering costs more than
    24 lines buy.
2026-07-25 docs(board): refresh the README's manual pointers — §5 is status & history, not a plan
2026-10-01 test(formal): the proofs check what they claim — keep every $equiv, add the CDC base case
    The in-situ core proof did not check the glue's wiring into the eight units.
    equiv_make puts the unit-input $equiv cells on nets only the merged black box
    reads; cutpoint removes the box, and the following `opt -full` swept those
    cells away before they were ever proven. Inverting the multiplier's signed
    flag in cpu.ml still passed. `setattr -set keep 1 t:$equiv` after equiv_make
    keeps them: the unmodified core still proves, and four wiring mutants (MUL
    sign flag, link register, FSB sign flip, shifter mode) now fail. The same line
    goes into the sequential, mouse and vid templates, which all prove uncha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
    [vid_invariant.v]
2026-10-01 test(cosim): the core replay can no longer vouch for a stale or shallow trace
    The boot trace is our core's own recorded behaviour, and the runner reused it
    whenever the file existed — so after a change to the core, @cosim replayed the
    old core against RISC5.v and passed. It is now recaptured on every run, and a
    hand-run cosim_run rebuilds its dumpers first (the @cosim rule declares them as
    deps and says so through COSIM_EXES_PREBUILT).
    The capture read the after-edge port refs after cycle_before_clock_edge, so
    each record was the state under the previous cycle's inputs; the replay hid
    that by not comparing the first two cycles. It now samples before-edge and
    every record is compared from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
    [core.cpp]
2026-10-01 test: property tests reach the corners and cannot pass on nothing
    QCheck.Test.check_exn defaults to a fixed seed and the generators were
    uniform, so every run replayed the same cases and never drew 0, the sign
    boundary or all-ones. Risc5.Test_gen is now the one entry point: the seed
    stays fixed (reproducible, stable expects) but QCHECK_SEED overrides it, and
    word32 / fp32 / divisor / signed mix corner values into the draws (the
    divisor log-uniform, so quotients of every width occur). The ALU, shifter,
    MUL, DIV and FP-multiplier properties and the FP fuzz use them.
    The UART and PS/2 byte round-trips tested the same 64 of 256 bytes forever;
    they are exhaustive loops now.
    The SoC's UART loopb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
2026-10-01 test(lockstep): bus strobes, full offsets, inert bits, programs under a random stall
    Each of these was a one-line design mutation the lockstep passed (the formal
    core proof caught them; the lockstep now does too):
    - loads and stores check the bus — full byte address, rd, wr, ben — where
    before only the store's word address and wr were looked at;
    - load/store offsets span the whole signed 20-bit field, not +-0x40, so a
    16-bit sign extension lands somewhere else;
    - register branches randomise every don't-care bit, including IR[5:4] on a
    linking branch, so the ~v guard on RTI/STI/CLI is exercised;
    - unsigned MUL' with C1[31] set is no longer skipped: everything is compared
    with the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
2026-10-01 test(board): the gates boot what ships, watch the pixels, and face a strict chip
    No simulation gate booted the shipped configuration: with every knob set the
    board golden still ran the 4 KiB cache and the iterative multipliers, and the
    checkpoint ran the bare controller. Build_config.shipped is now the one
    statement of the shipped knobs — the emitter uses it (soc_board.v is
    byte-identical) and both board gates default to it, with strictly parsed
    environment overrides as controls. The checkpoint runs the bare controller,
    then the shipped configuration.
    The goldens compared framebuffer memory and nothing in test/ looked at rgb.
    After the framebuffer verdict they now scan one raster frame of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
2026-10-01 docs(rom): say where the boot image comes from; fetch-rtl needs neither git nor network when cached
    rom.mli said the image was transcribed from the archive's prom.mem. It is the
    emulators' risc-boot.inc: the 2018 OberonStation archive ships a later build
    of the boot loader that agrees in its first 338 words and differs in 45 after
    (how SP and SB are initialised, and every call displacement behind that). The
    ROM circuit's async read is a modelling choice with no co-sim or proof row,
    not something "deferred".
    fetch-rtl.sh located the repo with `git rev-parse`, which fails in a release
    tarball; it now uses its own path. An already-downloaded archive whose
    checksum still matches is reused inste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
2026-10-01 refactor(board): the SoC takes one Build_config; the multipliers are one choice
    The board Soc.create had 16 optional knobs, forwarded by hand through the
    test bench in soc.ml, through board_tb, and again by every gate and gauge;
    create_config sat beside it as a second way in. It now takes a Build_config.t
    and nothing else. Build_config.bare is the all-off baseline (2-cycle PSRAM
    phases, no cache, shadow or buffer, the iterative multipliers, the 25 MHz
    machine's constants); tests, the checkpoint's first pass and the bench build
    from it with `{ bare with ... }`. ?video stays an optional argument outside
    the record: it is a simulation-only seam and has no place in a statement of
    what the bitstr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
2026-10-01 test(bench): the board bench measures what ships, a gauge at a time, in four minutes
    bench_boot was the memory arc's experiments replayed in sequence: fifteen
    sections, a dozen boots, twenty minutes, all on the machine of the time (4 KiB
    cache, iterative multipliers, 25 MHz constants) under labels that said
    "shipped". It is now three gauges over Board_tb.config_of_env — what the
    bitstream ships unless the gates' knobs say otherwise:
    profile every clock of a 2 M-instruction window, by what the core did
    ladder the memory stack put back a layer at a time, each rung compared
    with the one above over the same work
    autopsy every cache miss classified by an independent mo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
2026-10-01 test: the boot harness is one library in test/boot; @gates runs every gate
    The four boot gates, the core co-sim capture and two gauges shared three
    libraries loose in test/ — sd_bridge, boot_tb, and boot_checkpoint_common,
    which despite its name also owned the disk image, the oracle wiring and the
    whole visual-golden half. They are one library, boot, in test/boot/:
    Boot.Disk the disk image and a run's scratch copy
    Boot.Oracle the emulator, wired as its frontend wires it
    Boot.Checkpoint the handoff snapshot and the §8-aware comparison
    Boot.Golden framebuffer geometry, the oracle's desktop, settle loop,
    verdicts
    Boot.Sd_bridge the SD card on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
    [core.cpp]
2026-10-01 fix: knobs that cannot work fail at elaboration; the clock's three statements are checked against each other
    Guards, each with its message pinned by a test:
    - Cellram accepted write_cycles 1. WE# is low for all but the last cycle of a
    write phase, so a 1-cycle phase never pulsed it and every store was lost in
    silence. The lower bound is 2.
    - The pipelined multipliers took any `stages`; their run counter is 4 bits.
    1..15.
    - The UARTs took a divisor of 0. 1..4095 (the 12-bit tick).
    - Peripherals let two extra read slots claim the same word.
    The write buffer allows depths 1..4 and only 1 and 2 were tested. Two tests now
    hold every depth to the same contract: `depth` stores retire back-to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
2026-10-01 test: one mouse device model, a bench for the cellram tests, a QCheck property for Halftone's geometries
    The PS/2 mouse that plays against the port existed twice, in lib/mouse.ml's
    test and in the co-sim dumper. It is Mouse.For_tests.Device now, used by both;
    the dumper records its trace through an on_cycle hook, and its output is
    byte-identical (504,918 lines). ps2_dump takes its framing from
    Ps2.For_tests instead of a second copy; its output is identical too.
    The cellram tests each rebuilt the same sim, handles and idle levels and
    spelled every store as an eleven-line call. They stand on a Bench module
    (create, request, release, store, load, store_cost, video_request, idle):
    150 lines few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
2026-10-01 docs(comments): the pilot cut — the core, the PSRAM controller's contract, the build knobs
    Comments in five files are cut to what a reader of the code needs: why a thing
    is the way it is, the hazard or invariant behind it, where the structure
    mirrors the RTL. History (phase numbers, branch names, earlier clock rates),
    measurement narratives, section references into the manual, narration of the
    next lines, and .ml comments that repeat the .mli are gone. 439 comment-only
    lines become 221.
    Facts corrected on the way: the knob rationale speaks of the 64 MHz clock it
    is built for; the sixth read clock cost 0.86% when measured, not "~0.5%"; the
    interrupt logic is checked by the formal core proo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
2026-10-01 docs(comments): the sweep — the faithful machine (lib/)
    The pilot's cut, carried over every module of the faithful port. Comments
    keep the why, the hazard or invariant, and where the structure mirrors the
    RTL; history, measurement narratives, section references into the manual,
    narration of the next lines, and .ml comments that repeat the .mli are gone.
    Each .ml header names the Verilog file it ports and points at the .mli for
    the contract. 1,656 comment-only lines become 1,093.
    Facts corrected on the way: the FP divider takes 26 restoring steps, at
    S = 0..25; the FP adder's second operand is used by FLT and FLOOR (the
    compiler supplies 2^23); the divider's y > 0 precondition is the compi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
2026-10-01 docs(comments): the sweep — the board layer and its vendor files
    The same cut over board/nexys-4: the PSRAM controller and its chip model,
    the cache, the framebuffer shadow, Halftone and the board SoC. 1,002
    comment-only lines become 754.
    The hand-written files are brought up to the machine that ships.
    nexys4_top.v no longer speaks of 60 MHz, mul_stages or an emitter file that
    does not exist; the reset delay, the LED persistence and the heartbeat are
    stated for 64 MHz, and SD_RESET's polarity is stated, not left to verify.
    nexys4.xdc states the read and write budgets for 64 MHz (a 93.75 ns read
    phase, 62.5 ns to the rise of WEn) and points at build_config.ml for why the
    phases are 6 and 5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
    [nexys4.xdc, nexys4_top.v]
2026-10-01 docs(comments): the sweep — the tests, the proofs and the build files
    The same cut over test/: the lockstep, the FP replays, the boot harness and
    its gates, the board gates, the co-sim dumpers and runner, and the formal
    runner. 1,147 comment-only lines become 916. The comments of the dune files,
    .gitignore, fetch-rtl.sh, the proof templates and shims, and core.cpp lose
    their phase numbers and their section references into the manual.
    Corrections: core_dump's default cap is 10 M cycles, not 2 M; the two video
    comments in formal_run that disagreed now say one thing (the look-ahead is
    closed by vid_addr, vid_invariant and one hand step); the request-crossing
    proof is k-induction with a base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
    [core.cpp, core_stubs.v, mouse_shim.v, registers_spec.v, vid_invariant.v, vid_stubs.v]
2026-10-02 docs: a README for the release; the board, proof and co-simulation READMEs brought up to date
    README.md replaces the placeholder: what the machine is, how it is checked,
    the measured cost of each layer of the memory stack (27.80 clocks per
    instruction behind the PSRAM alone, 1.30 as shipped), how to build and test,
    how to put it on a board and an SD card, the documents, the related
    repositories, credits.
    board/nexys-4/README.md describes the machine that ships: 64 MHz, the
    configuration as a table with its reasons, the ladder, a section on Halftone
    and one on clocks and timing (why 64 MHz, the write phase's deviation from
    the datasheet, the margin the build closes with). The measurement sto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
2026-10-26 test(cosim): a dump the harness cannot read whole fails the unit
    Each harness read its dump with fscanf and stopped at the first record it
    could not parse, then reported zero mismatches. An empty dump passed, and so
    did one whose first line no longer parsed after a change to a dumper's
    format: the unit checked nothing and exited 0. A garbled or truncated record
    passed on the records before it, and a trace longer than its buffer spilled
    into the next record.
    cosim.h gains record_read, which tells a clean end of file from a short or
    unparseable record, and check_trace, which rejects a trace that fills its
    buffer. Every harness reads through them, rejects a dump with no records,
    and ends with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
2026-10-26 build(opam): the formal libraries, a Hardcaml floor, the license and the source
    The package now lists hardcaml_verify and hardcaml_of_verilog, which the
    proofs in test/formal need (a plain dune build builds them). The Hardcaml
    packages take v0.18~preview as their floor: v0.17's API differs. The
    license (MIT) and the GitHub source give the opam file its license,
    homepage, bug-reports and dev-repo fields, and the description names the
    emulator by its repository instead of risc_core.
    opam lint passes; opam install . --deps-only resolves on the 5.2.0+ox
    switch.
    Claude-Session: https://claude.ai/code/session_01EAC3xgsVcDMrxN8zCE6vg7
2026-10-26 docs: the README before v0.1.0, a photo of the board, and THIRD_PARTY.md
    THIRD_PARTY.md lists what in this repository derives from other work and
    carries the notices: lib/ as a port of the Project Oberon Verilog, the boot
    image in lib/rom.ml (Peter De Wachter's transcription), the stubs and
    wrappers that reproduce reference port lists, the pins in nexys4.xdc
    (Digilent's master XDC, MIT), and the emulator submodule. The three notice
    texts are byte-identical to their sources.
    The README:
    - shows the machine: a Nexys 4 beside its monitor, DOOM in a viewer
    (docs/oberon-on-nexys4.jpg, 1600x1200, 238 KiB, no metadata beyond its
    Display P3 profile);
    - names the video controller's two deliberat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
